KnArF9/projetDrone/README.md

# projetDrone
Projet électronique d'un drone
  - KiCad schéma, PCB
  - Rapport
  - Code tests unitaires
