KnArF9/projetDrone/rapportFinalDrone.pdf

## Cégep de Sherbrooke

## Technologie de systèmes ordinés

## Documentation projet Drone

## Pour le cours de ISO

## Pour : M. Pierre Bergeron

## Par : François Archambault

## Session Automne 2020

## Table des matières:

### INTRODUCTION AU PROJET :

Le but de ce projet était de concevoir l’électronique d’un drone et de le faire fonctionner. Pour ce rapport, je ne vais que traiter du côté matériel du projet parce que je n’ai pas vraiment commencé la programmation et l’application en Java n’est pas commencée.

Voici le schéma fonctionnel de mon projet :

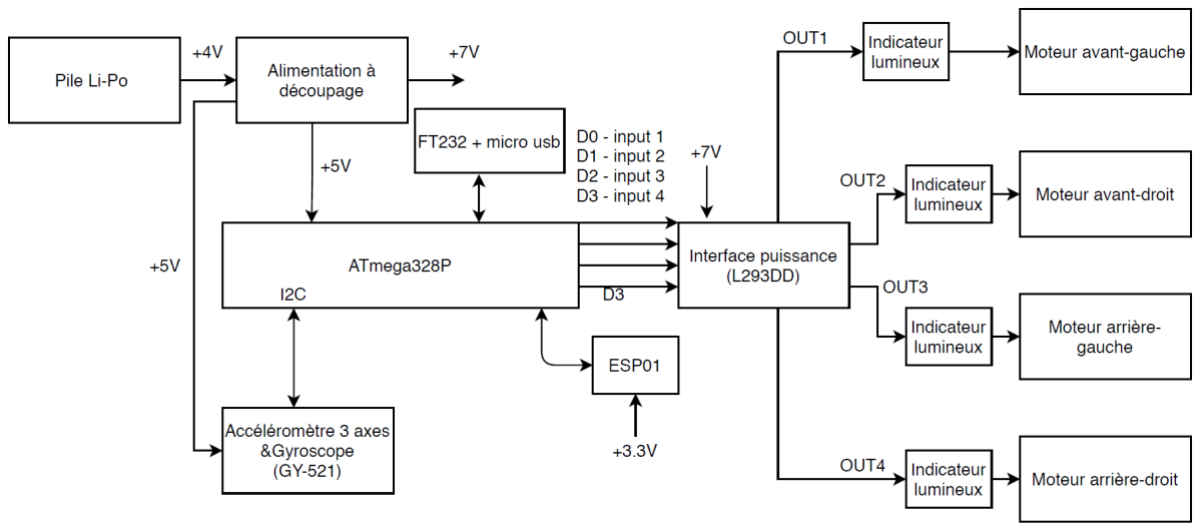
[picture p1: figure]

Figure 1

Il y a quelques erreurs dans ce schéma, mais malgré cela, le fonctionnement de base est comprenable. L’électronique du drone sera alimenté par une petite batterie Li-Po 4.5volts et 1.5 A/heure. Il y a un microcontrôleur qui gère le traitement des données du gyroscope, de l’esp01 et il contrôle les ponts en H des moteurs. Le gyroscope fournit au microcontrôleur des données sur l’accélération et la position en x et y du drone. L’esp01 gère la connexion Wi-Fi avec la future application Java sur cellulaire. Plusieurs témoins lumineux sont présents pour indiquer dans quel sens les moteurs tournent. L’alimentation à découpage monte la tension à 7v ou 9v pour alimenter les moteurs (en fait les ponts en H).

### CHOIX DES TECHNOLOGIES :

J’ai décidé de travailler avec un Atmega328PB parce que je commence à bien le connaitre et souvent, dans d’autres projets, j’ai dû travailler avec ce microcontrôleur. L’Atmega328PB a assez de pins PWM pour permettre le bon fonctionnement du drone. Pour le projet, j’ai mis le bootloader de Arduino pour pouvoir utiliser l’IDE et les librairies d’Arduino.

Les autres pièces ont été suggérées par le professeur. Honnêtement, je n’aime pas beaucoup l’esp01 parce qu’il n’est vraiment pas stable et il y a souvent des problèmes de communications. Mais bon… Ça marche quand même et ça ne coûte presque rien!

Je ne connaissais pas le gyroscope, mais j’avais déjà utilisé les ponts en H dans un projet personnel (bateau téléguidé).

### EXPLICATIONS DU SCHÉMA ÉLECTRIQUE :

(Le schéma électrique se trouve dans l’annexe 2 à la fin du document)

Le schéma électrique a été fait avec KiCad et il y a 4 parties au schéma. Les parties sont : alimentation, microcontrôleur et gyroscope, moteurs et esp01.

Alimentation : Dans cette partie, toutes les connexions de l’alimentation à découpage sont présentes ainsi que les régulateurs 5v et 3v3. Il y a aussi le jumper qui permet de choisir entre une tension de sortie de 7 ou 9 volts. (Figure 2)

Microcontrôleur : Dans cette partie, il y a les connexions du FT232 qui sert à la communication série entre un ordinateur et l’Atmega328PB. Il y a aussi le gyroscope qui est connecté au microcontrôleur en I2C. Il y a aussi les jumpers qui servent à contrôler les liens séries entre l’esp01, le FT232 et l’Atmega328PB. (Figure 3)

Moteurs : Dans cette partie, il y a les moteurs, les témoins lumineux et les ponts en H. Plusieurs pins des ponts en H sont connectés à des sorties du microcontrôleur (Les Dx ou Ax). Pour réussir à appliquer des PWMs sur les moteurs, il faut utiliser les pins enables des ponts en H et les pins inputs. Les pins inputs servent à choisir sur quel moteur le PWM va être appliqué et c’est sur les pins enables que le PWM va être transmis au moteur. Exemple : Le moteur 1 est connecté à l’input 1 et 2 d’un pont en H. Si l’input #1 est à un niveau haut, le moteur va aller dans le sens antihoraire et si c’est l’input #2 qui est à un niveau haut, le moteur va aller dans le sens horaire. Cependant, pour fonctionner il faut que le pin enable du moteur soit à un niveau haut! Si un PWM est appliqué sur la pin enable, le PWM va se retrouver dans le moteur. (Figure 4)

Esp01 : Dans cette partie, il n’y a que l’esp01 avec les boutons pour le programmer et une del témoin pour démontrer que la connexion est bien présente. (Figure 5)

### PROBLÈMES RENCONTRÉS :

Plusieurs problèmes sur le matériel sont survenus durant la conception. Dans la première version du drone, il y avait plusieurs erreurs de branchements entre le microcontrôleur et les ponts en H qui contrôlent les moteurs. Dans la première version, l’ATmega328PB n’aurait pas pu générer des PWMs sur tous les sens des moteurs. Malgré les erreurs, le PCB a été fabriqué et assemblé. Le PCB était fonctionnel sauf pour les PWMs. Le microcontrôleur fonctionnait bien ainsi que la communication série. Le PCB a malheureusement surchauffé à cause d’une erreur de son concepteur en branchant la batterie. Le cavalier qui donnait une référence (7v ou 9v) pour le circuit d’alimentation du drone a été enlevé et le circuit a brulé.

Il a donc fallu une version 2 du PCB avec les corrections nécessaires pour le fonctionnement des PWMs. Le PCB fut monté et à la plus grande joie du concepteur, tout est fonctionnel dans la version 2 de la plaque.

## ESP01 :

Dans le projet du drone, l’esp01 sert à faire le lien entre l’application cellulaire qui va envoyer les changements voulus et le microcontrôleur qui contrôle les moteurs du drone. L’esp01 reçoit des trames par le port série. Premièrement, l’utilisateur doit connecter l’application avec l’esp01 du drone. Il doit aller dans la section configuration de l’application et entrer l’IP, le port et l’ID pour la connexion (Dans ce projet : Port : 8888 & ID : crap8266). Si l’utilisateur demande de changer la direction du drone en appuyant sur une direction (4 boutons sur l’application), la trame envoyée à l’esp01 par l’application sera la direction avec une petite étoile (ex : Front*). Si l’application envoie une vitesse (avec le curseur), la vitesse sera envoyée avec un « / » (ex : 56/).

Quand la trame vient du microcontrôleur, les informations ne sont plus des directions ou bien une vitesse, mais les valeurs X, Y, Z de l’accéléromètre qui se trouve sur la plaque du drone. La trame reçue ressemble à ça : « 1234 5667 6374/*». La première section de la trame est le X, la deuxième Y et finalement la troisième Z. La trame se termine avec « /* » parce que dans le code de l’esp01, l’esp01 écoute le port série jusqu’à temps qu’il voit une petite étoile (*). Une fois qu’il voit la petite étoile, il transmet la trame à l’application CodeNameOne. La trame envoyée sera donc : « 1234 5667 6374/».

## ATMEGA328PB :

Dans le projet, l’Atmega328PB est le microcontrôleur qui contrôle les moteurs (donc PWM) du drone. Il active les moteurs avec les trames qu’il reçoit de l’application CodeNameOne avec le lien que fait l’esp01. Les trames reçues ressemblent à cela : « Front*» ou bien «76/». Le programme de l’ATmega328PB écoute le port série qui est connecté avec l’esp01. Quand quelque chose arrive par le port série, les caractères sont mis un à un dans une variable string (command). Si le caractère reçu est une petite étoile (*), cela veut dire que c’est une direction qui a été envoyée et l’ATmega328PB fait les ajustements par rapport à la commande. S’il reçoit la commande « Front », il va faire avancer le drone.

Si le caractère reçu est « / », cela veut dire que c’est une vitesse qui a été envoyée. La vitesse influence le PWM généré sur les moteurs.

Quand il a reçu une trame, l’ATmega328PB construit une variable string (valeurACC) qui contient les valeurs X, Y et Z de l’accéléromètre. Cette variable va être envoyée à l’esp01 par le port série pour finalement être reçu par l’application sur cellulaire. L’application pourra ensuite afficher les données de l’accéléromètre.

### APPLICATION CODENAMEONE :

L’application cellulaire fait avec CodeNameOne et l’IDE NetBeans, sert à contrôler le drone à partir d’un cellulaire. Dans la fenêtre principale de l’application (Annexe 4 pour l’apparence de l’application), il y a trois parties. La première (en haut) permet de contrôler la direction du drone grâce aux quatre boutons qui figurent les directions Nord, Sud, Est et Ouest. Quand l’utilisateur appuie sur un des quatre boutons, l’application envoie une requête TCP vers l’esp01 qui se trouve sur le drone. Si l’utilisateur appuie sur le bouton qui fait avancer le drone, la commande (ou trame) envoyée sera : « Front* ».

La deuxième partie (curseur) sert à changer la vitesse du drone. Le curseur peut aller de 0 à 100. La trame envoyée sera : « 21/ ».

La troisième partie sert à afficher les valeurs de l’accéléromètre du drone (X, Y, Z).

Cependant, avant de pouvoir envoyer des commandes au drone, il faut connecter l’application avec le esp01. Pour cela, il faut aller dans le menu (3 petits points en haut à droite) et choisir l’onglet Configuration. Dans cette fenêtre, il est possible d’entrer l’IP, le port et l’ID de l’esp01 du drone. Si une des trois informations n’est pas valides, il n’y aura pas de connexion. L’ID sert à vérifier si les commandes arrivent bien du drone sur lequel l’application est connectée.

Sinon, dans le menu, il y a aussi un onglet « À propos de… » et un onglet « Quitter ». En cliquant sur l’onglet « À propos de… », un message apparait pour montrer la version de l’application et le nom du concepteur. En cliquant sur l’onglet « Quitter », l’application se ferme.

## TCP :

Le drone et l’application communiquent avec l’aide de trames. Ces trames sont envoyées avec le protocole de communication TCP. L’esp01 est en réalité un serveur TCP qui attend qu’un client se connecte. L’application joue le rôle du client. À chaque fois qu’une trame est envoyée à partir de l’application, l’application se connecte au serveur TCP de l’esp01 et une fois que le
commande a été envoyée, le client (donc l’application) se déconnecte du serveur. De son côté, l’esp01 est toujours en attente d’une connexion d’un client. Quand un client est connecté, il reçoit la trame, il envoie le contenu de la trame sur le port série et il attend une réponse du microcontrôleur. Une fois que le microcontrôleur a envoyé sa réponse, l’esp01 envoie le contenu de la réponse au client (l’application).

### FONCTIONNALITÉS FINALES OBTENUES :

Le drone fonctionne bien. Toutes les parties ont été évaluées. Les codes nécessaires au fonctionnement du drone sont aussi fonctionnels, mais il y a quand même une petite erreur dans le programme de l’application CodeNameOne. Si l’utilisateur connecte correctement l’application à l’esp01 et qu’ensuite, il décide de changer l’ID sans changer le reste, le drone va continuer à recevoir les commandes malgré le mauvais ID. Cependant, si l’utilisateur tente de mettre un mauvais ID dans le première connexion à l’esp01, l’accès sera refusé.

### ANNEXE 1 (SIMULATION 7 ET 9V) :

Simulation 7v :

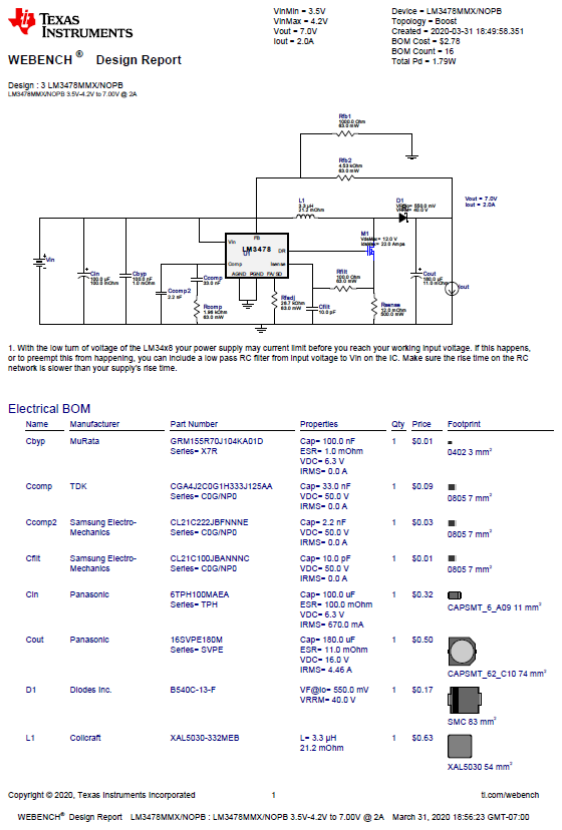
[picture p2: figure]
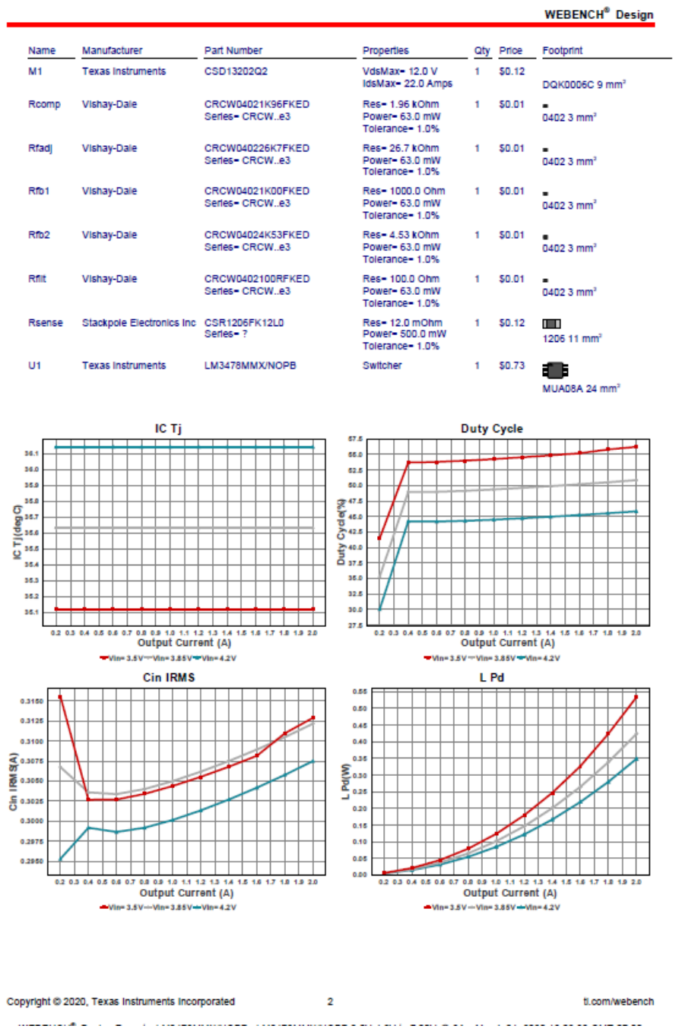
[picture p3: page 9]
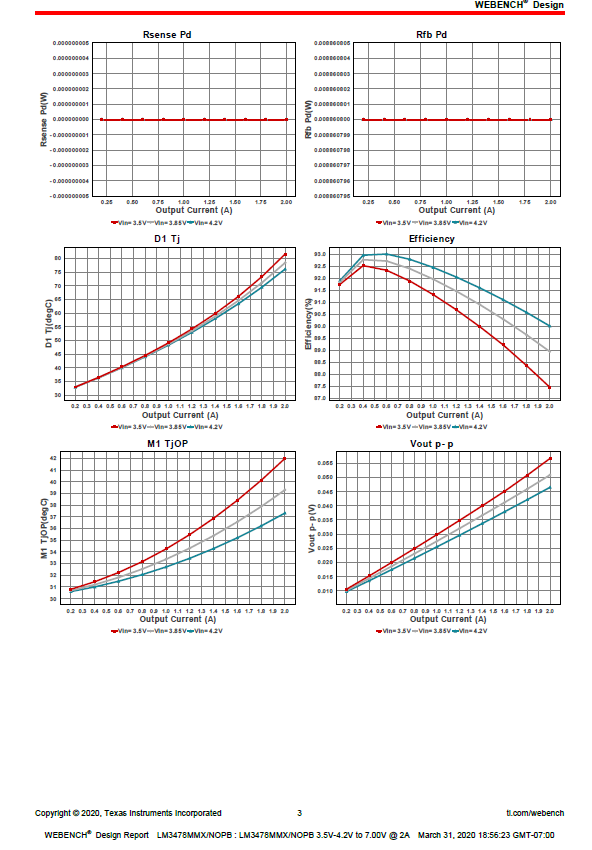
[picture p4: page 10]

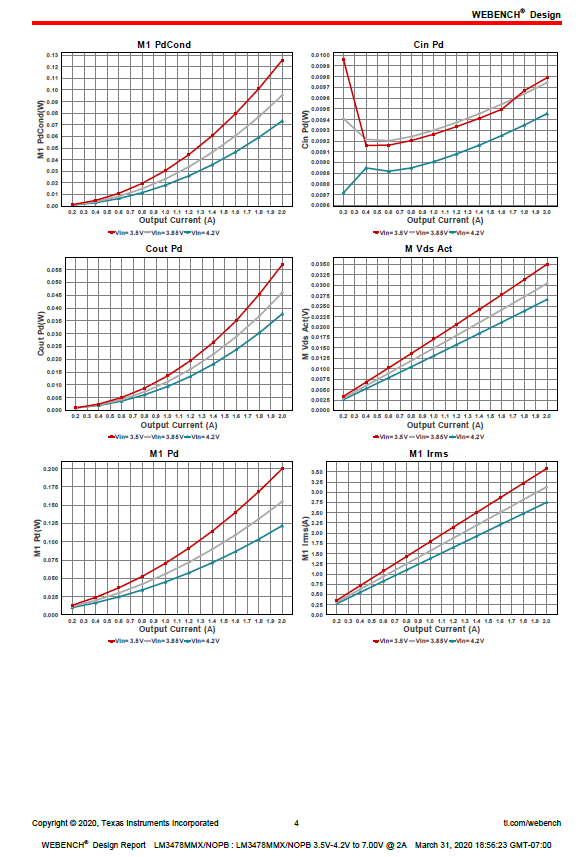
[picture p5: figure]
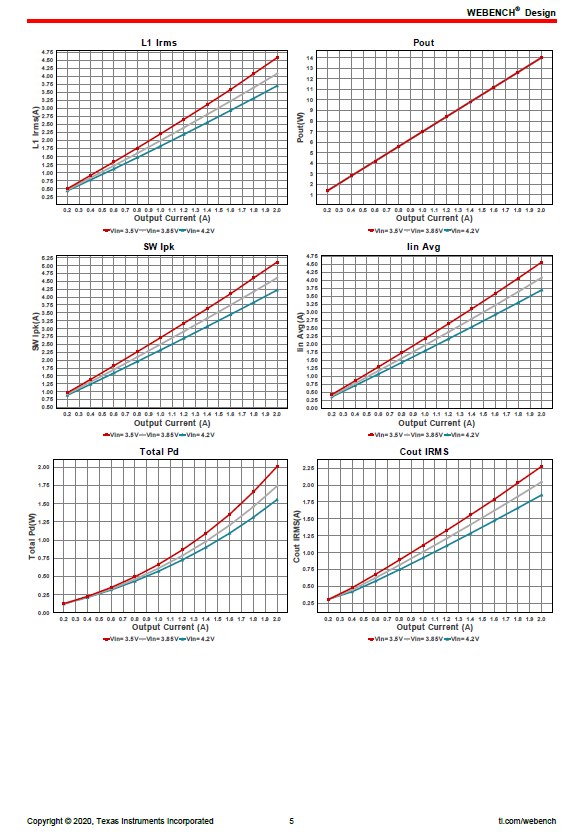
[picture p6: page 12]
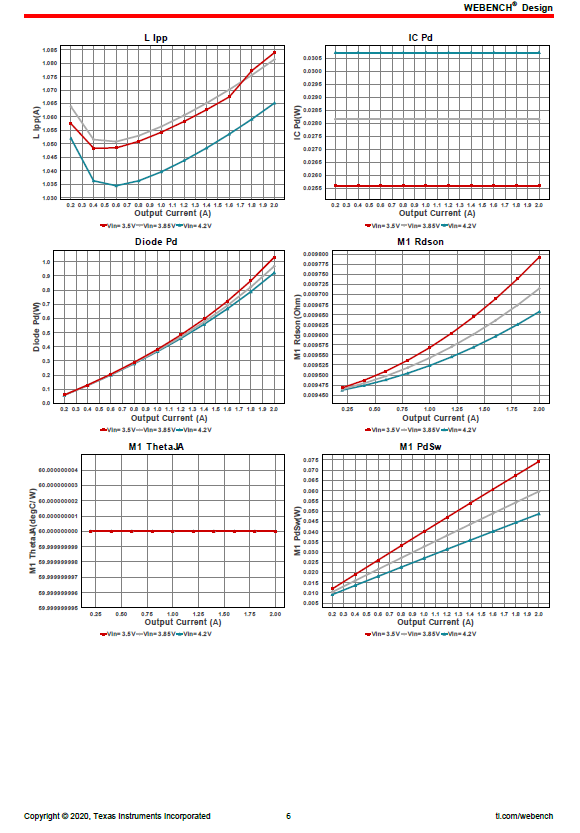
[picture p7: page 13]
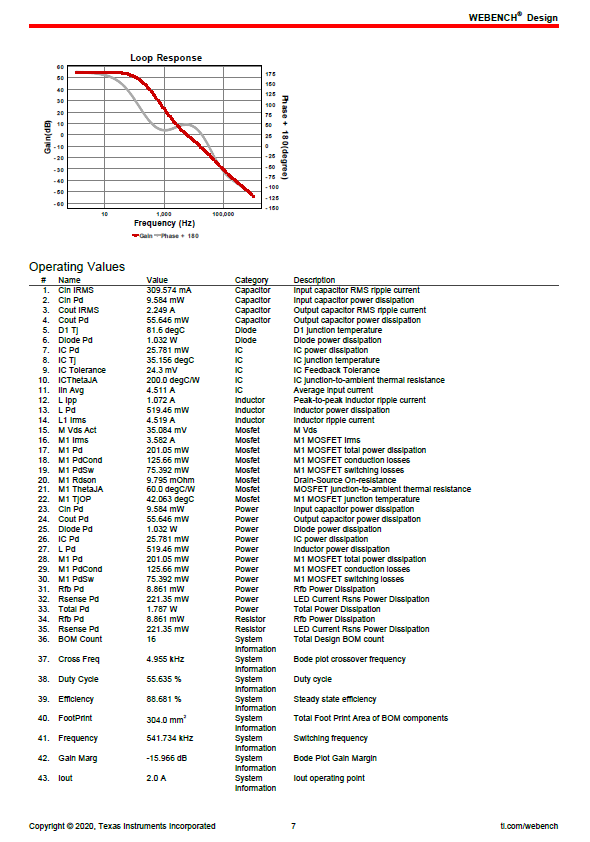
[picture p8: page 14]
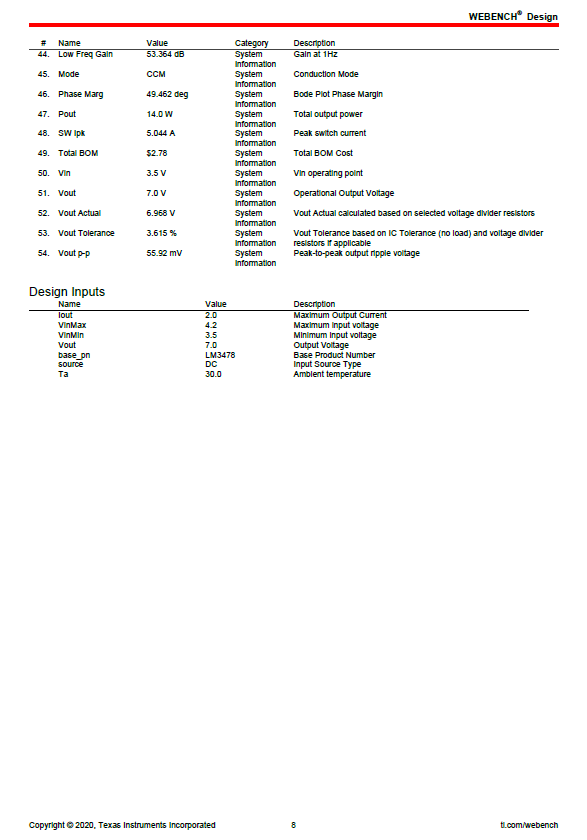
[picture p9: page 15]
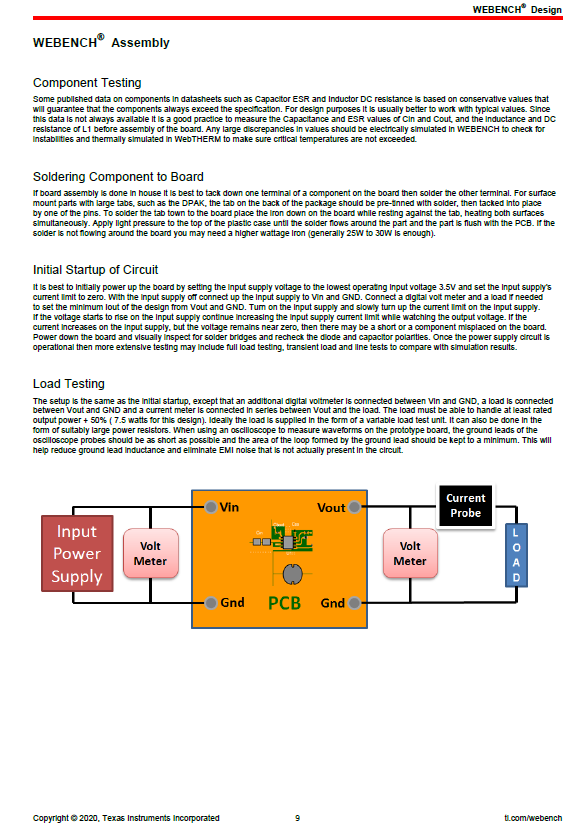
[picture p10: page 16]

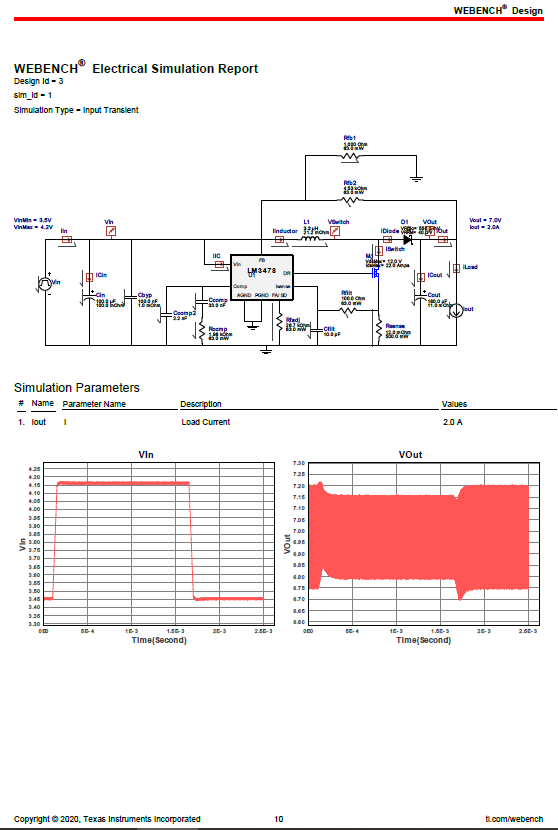
[picture p11: figure]
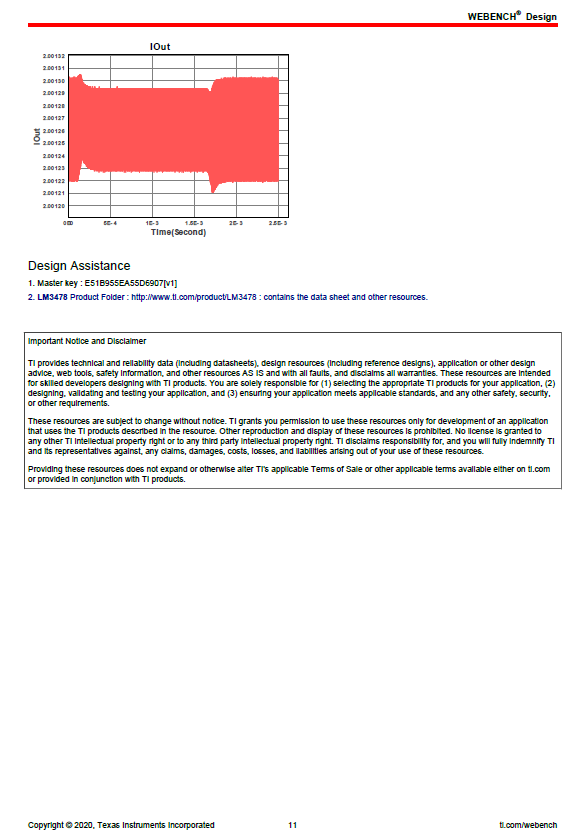
[picture p12: page 18]

Simulation 9v :

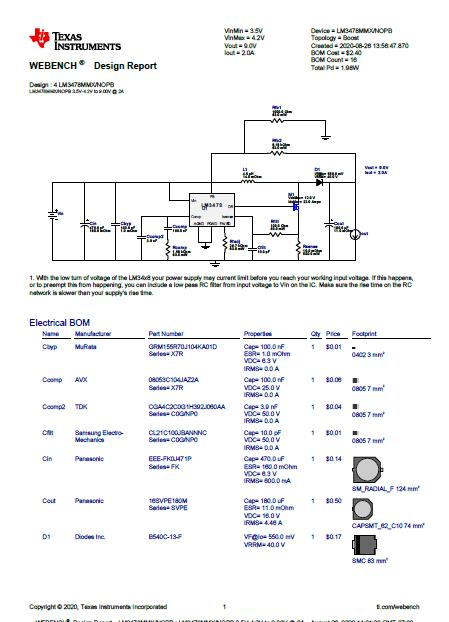
[picture p13: figure]
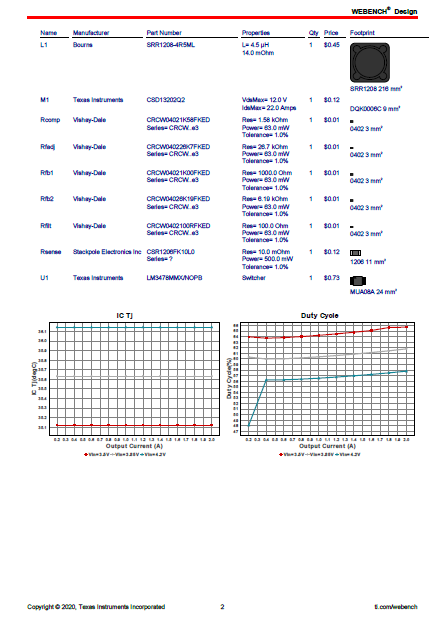
[picture p14: page 20]

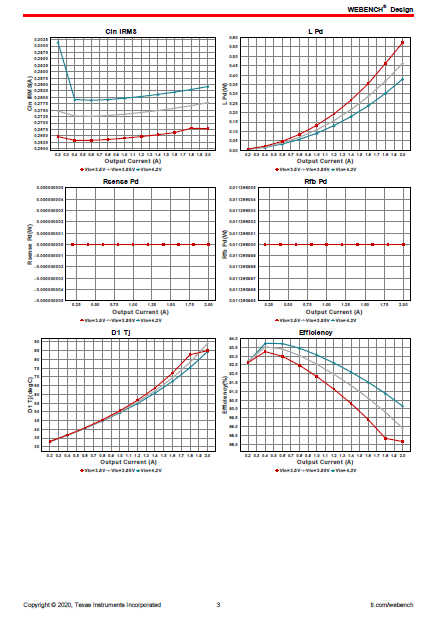
[picture p15: figure]
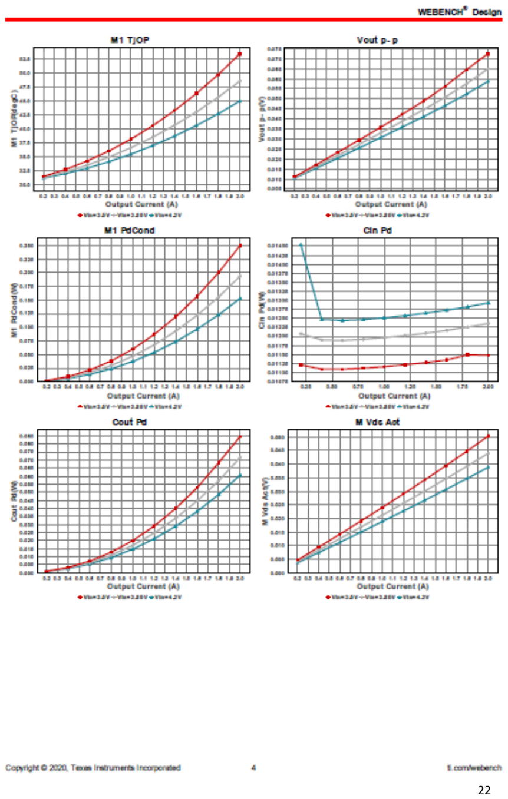
[picture p16: page 22]
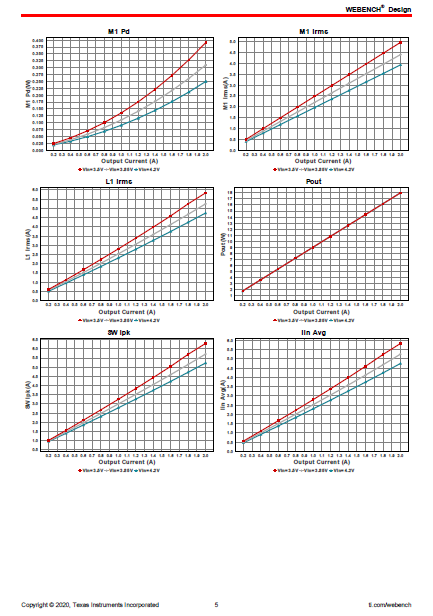
[picture p17: page 23]

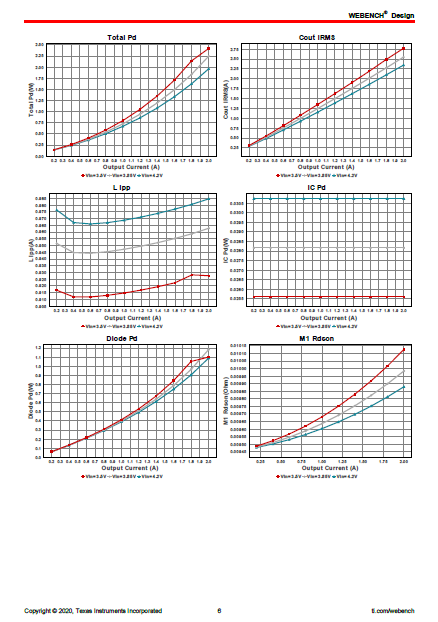
[picture p18: figure]

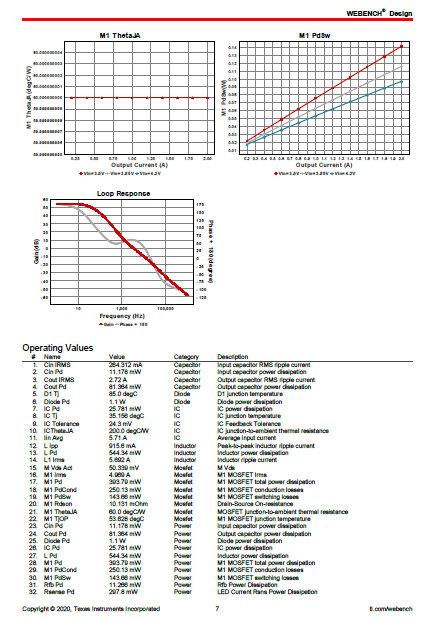
[picture p19: figure]

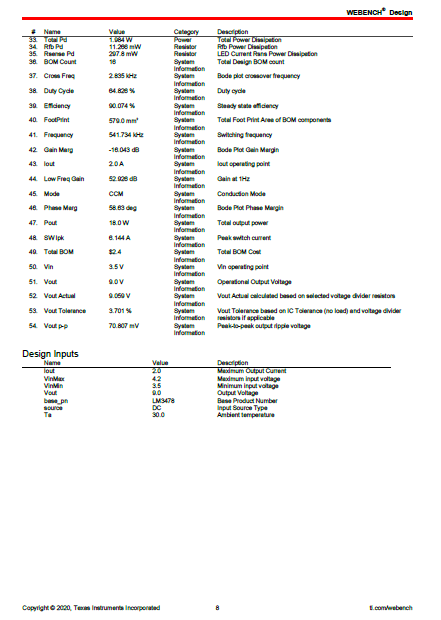
[picture p20: figure]

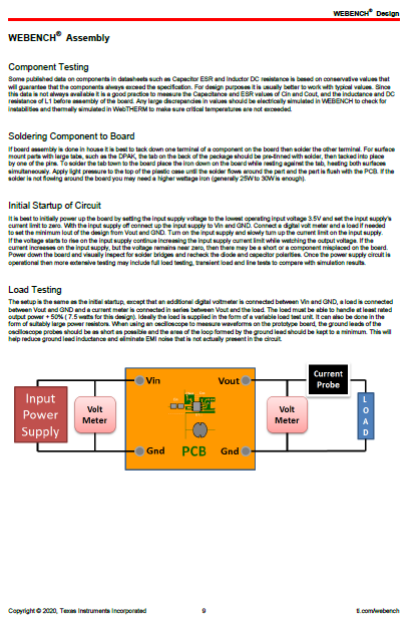
[picture p21: figure]

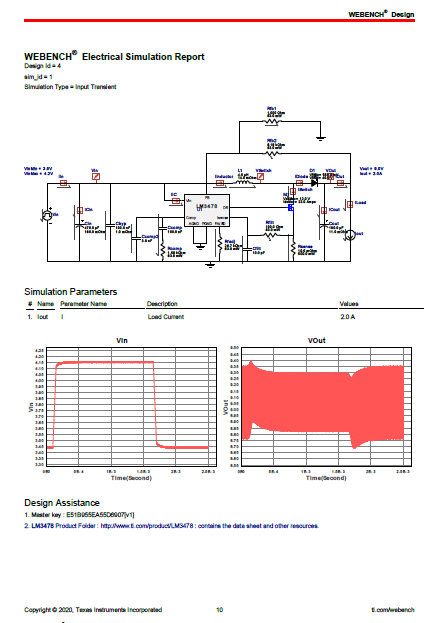
[picture p22: figure]

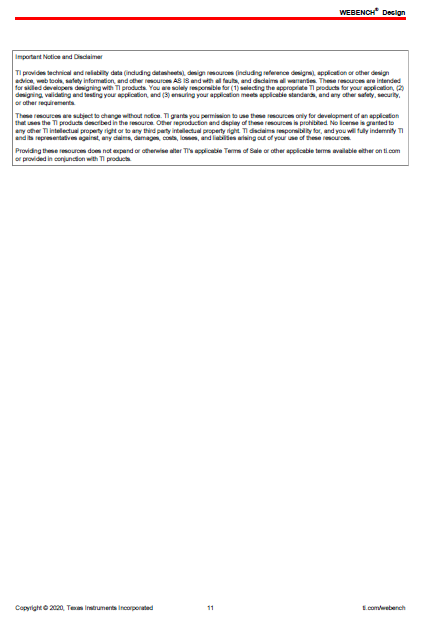
[picture p23: figure]

## Annexe 2(Schéma électrique) :

Figure 2

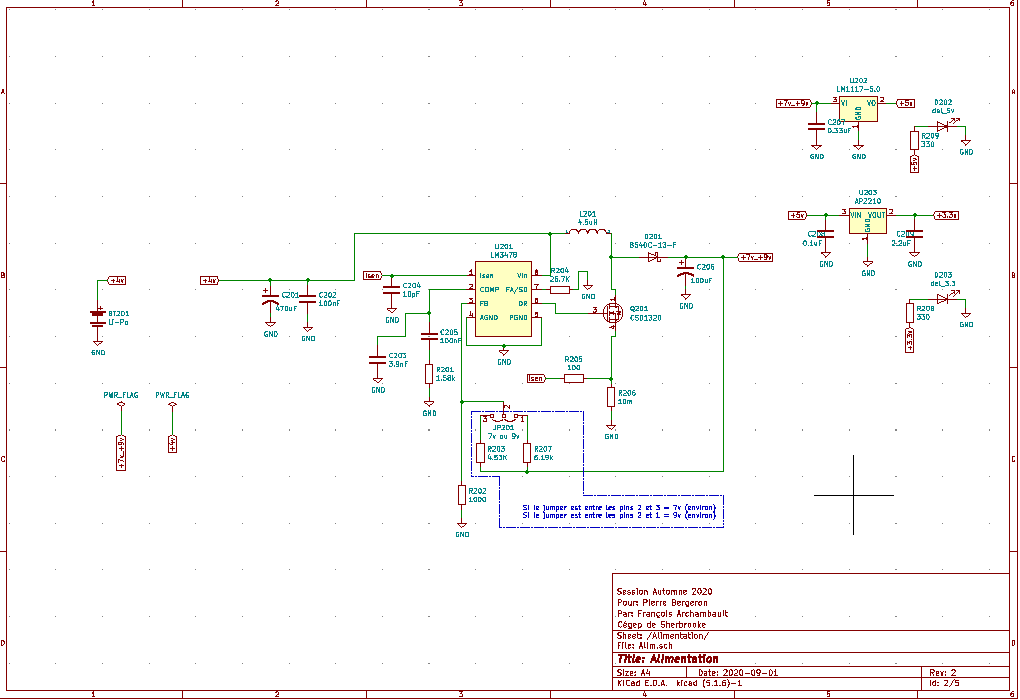
[picture p24: figure]

Figure 3

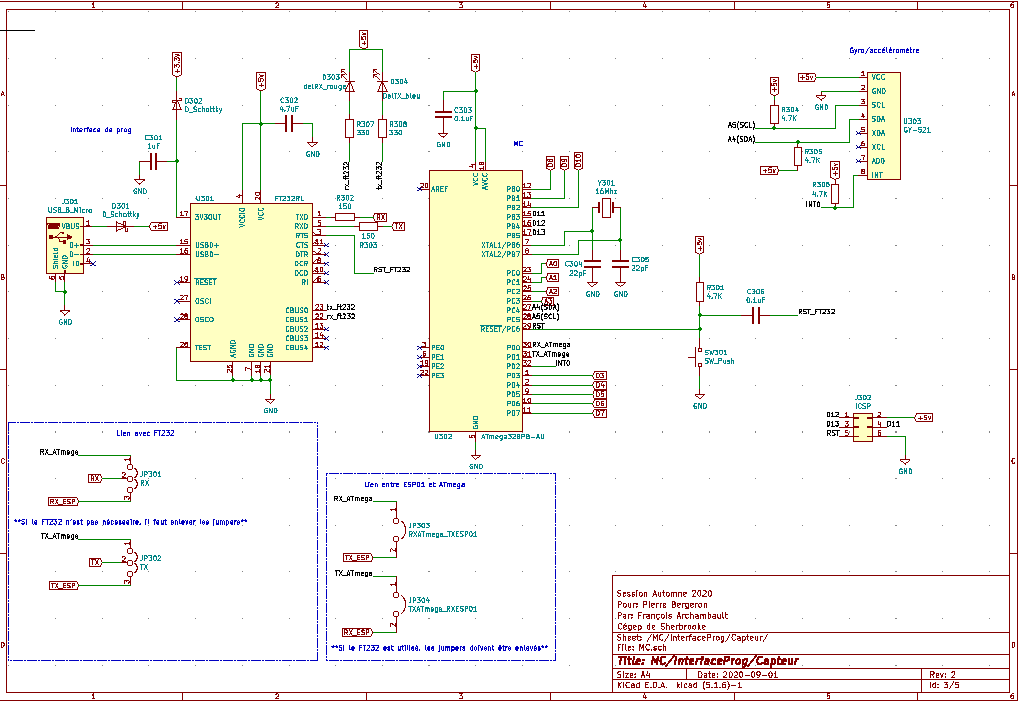
[picture p25: figure]

Figure 4

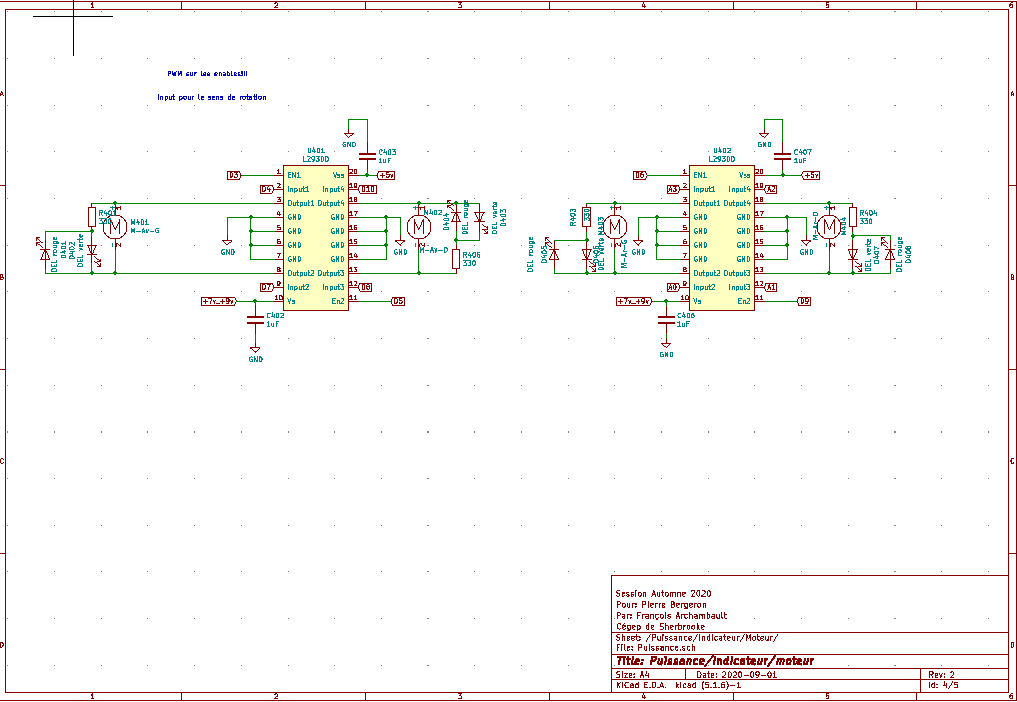
[picture p26: figure]

Figure 5

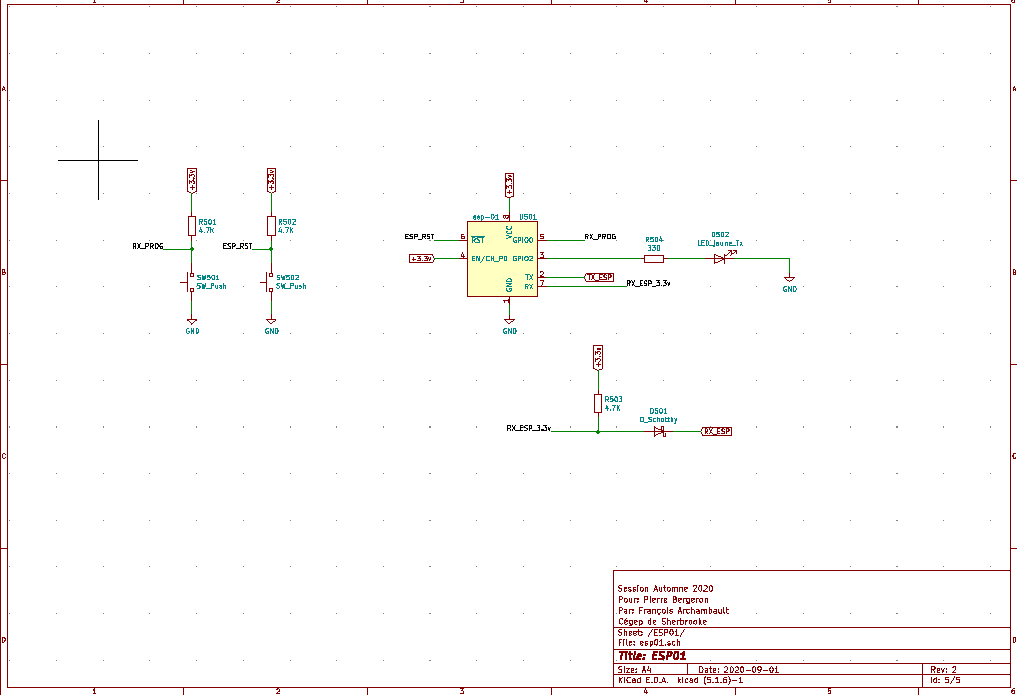
[picture p27: figure]

## Annexe 3 (vue 3D):

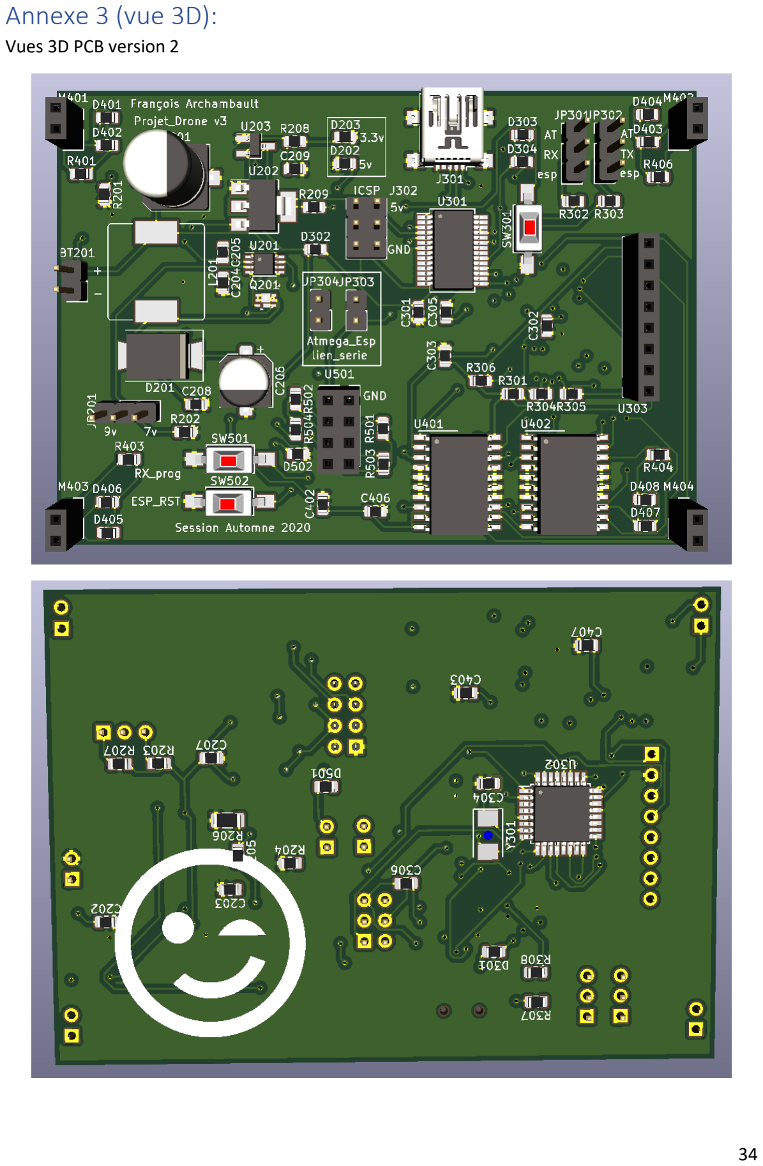
[picture p28: page 34]

Vues 3D PCB version 2

## Annexe 4 (Apparence des fenêtres de l’application):

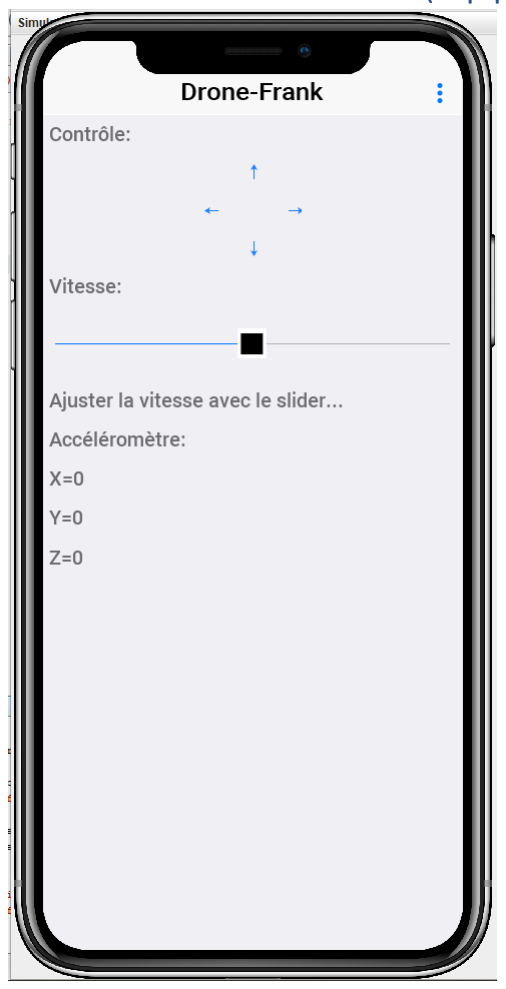
[picture p29: figure]
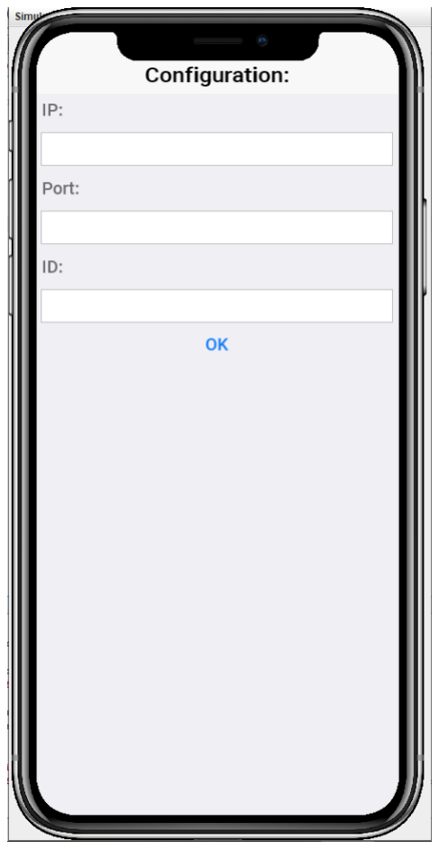
[picture p30: figure]
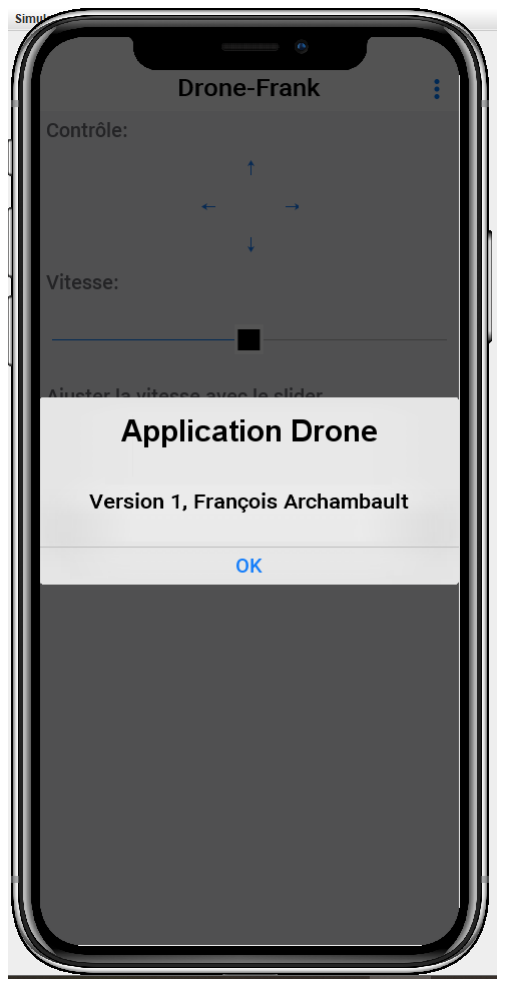
[picture p31: figure]

## Annexe 5 (CodeNameOne):

/*

* Programme de base pour le fonctionnement de l'application java.

* Par François Archambault

* Pour Pierre Bergeron

* Session Automne 2020

*/

package tso.cegepSherbrooke.droneFA;

import static com.codename1.ui.CN.*;

import com.codename1.ui.Display;

import com.codename1.ui.Form;

import com.codename1.ui.Dialog;

import com.codename1.ui.Label;

import com.codename1.ui.plaf.UIManager;

import com.codename1.ui.util.Resources;

import com.codename1.io.Log;

import com.codename1.ui.Toolbar;

import java.io.IOException;

import com.codename1.ui.layouts.BoxLayout;

import com.codename1.io.NetworkEvent;

import com.codename1.ui.Component;

import com.codename1.ui.layouts.FlowLayout;

/**

* This file was generated by <a href="https://www.codenameone.com/">Codename One</a> for the purpose

* of building native mobile applications using Java.

*/

public class monApp {

private Form current;

private Resources theme;

public void init(Object context) {

// use two network threads instead of one

updateNetworkThreadCount(2);

theme = UIManager.initFirstTheme("/theme");

// Enable Toolbar on all Forms by default

Toolbar.setGlobalToolbar(true);

// Pro only feature

Log.bindCrashProtection(true);

addNetworkErrorListener(err -> {

// prevent the event from propagating

err.consume();

if(err.getError() != null) {

Log.e(err.getError());

}

Log.sendLogAsync();

Dialog.show("Connection Error", "There was a networking error in the connection to " + err.getConnectionRequest().getUrl(), "OK", null);

});

}

public void start() {

if(current != null){

current.show();

return;

}

affichage aff = new affichage(); //appel à la classe affiche qui génère l'application

}

public void stop() {

current = getCurrentForm();

if(current instanceof Dialog) {

((Dialog)current).dispose();

current = getCurrentForm();

}

}

public void destroy() {

}

}

/*

* Fichier pour la section affiche de la fenêtre principale de l'application (classe affichage)

* Le programme gère aussi l'envoie des commandes et la résception des valeurs de l'accéléromètre par TCP

* Affiche les données de l'accéléromètre

* Par François Archambault

* Session Automne 2020

*/

package tso.cegepSherbrooke.droneFA; //doit avoir le même package que les autre fichier du programme

import static com.codename1.io.JSONParser.parse;

import static com.codename1.ui.CN.*;

import com.codename1.ui.Display;

import com.codename1.ui.Form;

import com.codename1.ui.Dialog;

import com.codename1.ui.Label;

import com.codename1.ui.plaf.UIManager;

import com.codename1.ui.util.Resources;

import com.codename1.io.Log;

import com.codename1.ui.Toolbar;

import java.io.IOException;

import com.codename1.ui.layouts.BoxLayout;

import com.codename1.io.NetworkEvent;

import com.codename1.io.Socket;

import com.codename1.io.SocketConnection;

import com.codename1.ui.Button;

import com.codename1.ui.Command;

import com.codename1.ui.Component;

import com.codename1.ui.Container;

import com.codename1.ui.Font;

import com.codename1.ui.FontImage;

import com.codename1.ui.Image;

import com.codename1.ui.Slider;

import com.codename1.ui.TextField;

import com.codename1.ui.events.ActionEvent;

import com.codename1.ui.layouts.BorderLayout;

import com.codename1.ui.layouts.FlowLayout;

import com.codename1.ui.layouts.GridLayout;

import com.codename1.ui.plaf.Border;

import com.codename1.ui.plaf.Style;

import java.io.InputStream;

import java.io.InputStreamReader;

import java.io.OutputStream;

import com.codename1.io.Util;

/**

*

* @author farch

*/

public class affichage extends Form

{

public Command cAProposDe; //onglet dans menu

public Command cQuitter; //onglet dans menu

public Command cConfig; //onglet dans menu

public String IP = ""; //variable pour l'IP public String PORT = ""; //variable pour le PORT

public String ID = ""; //variable pour l'ID

Label valueX = new Label("X=0"); //Labels qui vont accueillir les données de l'accéléramètre

Label valueY = new Label("Y=0"); //ne sont pas dans le constructeur parce que la méthode send a besoin de changer le texte des labels

Label valueZ = new Label("Z=0");

public affichage() //constructeur de la classe

{

setTitle("Drone-Frank"); //titre de l'application

setLayout( BoxLayout.y()); //layout de la fenêtre en box (bloc un par dessus l'autre)

Container panelControle = new Container(); //container

Container pGrid = new Container(); //

//instanciation de tous les labels utiles dans la fenêtre

Label lb = new Label("Contrôle: ");

Label vitesse = new Label("Vitesse: ");

Label value = new Label("Ajuster la vitesse avec le slider...");

Label accelerometre = new Label("Accéléromètre: ");

//instanciation des boutons utiles dans la fenêtre

Button bHaut = new Button("↑");

Button bBas = new Button("↓");

Button bGauche = new Button("←");

Button bDroite = new Button("→");

//Attribut une action au bouton. Ici c'est un appel à la méthode send avec une direction en paramètre

bHaut.addActionListener((e) -> send("Front*"));

bBas.addActionListener((e) -> send("Back*"));

bGauche.addActionListener((e) -> send("Gauche*"));

bDroite.addActionListener((e) -> send("Droite*"));

//section du slider

Style thumbStyle = new Style(); //pour mettre un curseur sur le slider

thumbStyle.setFont(Font.createSystemFont(Font.FACE_MONOSPACE, Font.STYLE_BOLD, Font.SIZE_LARGE), true);

Slider sliderVitesse = new Slider(); //instanciation

sliderVitesse.setEditable(true); //le slider peut changer de valeur

sliderVitesse.setMinValue(0); //MIN =0

sliderVitesse.setMaxValue(100); //MAX = 100

sliderVitesse.setProgress(50); //commence à 50 (milieu)

sliderVitesse.setThumbImage(FontImage.create("⬛", thumbStyle)); //le curseur est un carré

sliderVitesse.addActionListener(e -> { //attribut une action quand le slider change de valeur

Integer valueSelected = sliderVitesse.getProgress(); //valeur actuelle du slider (entre 0 et 100)

value.setText( valueSelected.toString() + "% de vitesse"); //change le texte de la vitesse pour afficher la vitesse (ex. 43% de vitesse)

String toSend = valueSelected.toString()+ "/"; //création de la string qui va être envoyée à l'esp01 par TCP

send(toSend); //appel la méthode send avec en paramètre la vitesse + / (ex. 34/)

});

//instanciation de labels vides pour remplir la grille pour faire le layout (nord, sud, est, ouest)

Label v1 = new Label("");

Label v2 = new Label("");

Label v3 = new Label("");

Label v4 = new Label("");

Label v5 = new Label("");

pGrid.setLayout(new GridLayout(3,3)); //grille de 3 par 3

panelControle.setLayout(new FlowLayout(Component.CENTER));

//ajoute à la grille tous les labels et les boutons pour faire le bon layout des directions

pGrid.add(v1);

pGrid.add(bHaut);

pGrid.add(v2);

pGrid.add(bGauche);

pGrid.add(v3);

pGrid.add(bDroite);

pGrid.add(v4);

pGrid.add(bBas);

pGrid.add(v5);

panelControle.add(pGrid); //ajoute la grille au panel

//ajoute tout à la fenêtre principale dans le bon ordre. (lb va être le premier en haut de la fenêtre et valuez le dernier)

add(lb);

add(panelControle);

add(vitesse);

add(sliderVitesse);

add(value);

add(accelerometre);

add(valueX);

add(valueY);

add(valueZ);

//onglet a propos de dans le menu

cAProposDe = new Command("À propos de...")

{

public void actionPerformed(ActionEvent ae) //quand appuyé

{

onAProposDe(); //appel à la méthode onAProposDe

}

};

//onglet Quitter de dans le menu

cQuitter = new Command("Quitter")

{

public void actionPerformed(ActionEvent ae)//quand appuyé

{

onQuitter();//appel à la méthode onQuitter

}

};

//onglet configuration de dans le menu

cConfig = new Command("Configuration")

{

public void actionPerformed(ActionEvent ae)//quand appuyé

{

onConfig();//appel à la méthode onQuitter

}

};

Toolbar tb = getToolbar(); //nouveau menu

tb.addCommandToOverflowMenu(cConfig); //ajoute les onglets au menu

tb.addCommandToOverflowMenu(cAProposDe);

tb.addCommandToOverflowMenu(cQuitter);

show(); //affiche les composantes de la fenêtre

}

public void onConfig()

{

new config(this); //appel à la classe config (autre fenêtre qui sert à l'affichage de la fenêtre de config

}

public void onQuitter()

{

System.exit(0); //quitte l'application

}

public void onAProposDe()

{

Dialog.show("Application Drone", "Version 1, François Archambault", "OK", null); //affiche un message

}

public void send(String bufferEnvoie) //méthode qui envoie une commande à l'esp01 par TCP

{

try

{

// Ouverture de la connexion au serveur sur le port 8888 (adresse localhost OK avec simulateur mais pas avec vrai mobile)

Socket.connect(IP, Integer.parseInt(PORT), new SocketConnection()

{

// Surcharge de la méthode pour la gestion des erreurs de connexion

public void connectionError(int errorCode, String message)

{

System.out.println("Error");

}

// Surcharge de la méthode lorsque la connexion est établie

public void connectionEstablished(InputStream is, OutputStream os) {

try {

if(isConnected()) {

os.write(bufferEnvoie.getBytes()); // Envoi le buffer de caractères contenant la commande

try

{

Thread.sleep(100); // Délai pour recevoir la réponse...

}

catch(Exception e)

{

System.out.println(e.toString());

}

InputStreamReader isr = new InputStreamReader(is); // Définir la source de donnée et le canal de communication

String inputLine;

StringBuffer response = new StringBuffer();

int nb = 0;

do

{

char[] cbuff = new char[1000];

nb=isr.read(cbuff, 0, 100); // Lecture de la réponse en cours (peut-être contenu dans plusieurs trames TCP)

inputLine = new String(cbuff);

response.append(inputLine);

}while (is.available()>0);

isr.close(); // Fermeture de la connexion

//Affiche la réponse reçue

System.out.println(response.toString());

String[] valAcc1 = Util.split(response.toString(),"/"); //divise la réponse au "/" et c'Est mis dans un tableau de string

String[] valAcc2 = Util.split(valAcc1[0].toString()," ");//divise le tableau valAcc1 à l'index 0 au " " et c'Est mis dans un autre tableau de string

int longueurAcc = valAcc2[5].length(); //prend la longueur de l'ID (valAcc2[5])

int longueurID = ID.length();

//if(valAcc1[5].equals(ID))

if(longueurAcc == longueurID) //compare la longueur de l'ID et de l'ID reçu par TCP. SI pareil

{

valueX.setText("X: " + valAcc2[2].toString()); //change les valeurs de x y z par les nouvelles

valueY.setText("Y: " + valAcc2[3].toString());

valueZ.setText("Z: " + valAcc2[4].toString());

// ID = valAcc[3];

}

for(int i=0; i< valAcc2.length;i++) //vide le tableau

{

//valAcc1[i]="";

valAcc2[i]="";

}

}

} catch(Exception err) {

err.printStackTrace();

}

}

});

}

catch(Exception e)

{

e.printStackTrace();

}

}

}

/*

* Fichier de la fenêtre de configuration. Permet de changer les variables de connexion de l'application.

* Par François Archambault

* Session Automne 2020

*/

package tso.cegepSherbrooke.droneFA;

import static com.codename1.ui.CN.*;

import com.codename1.ui.Display;

import com.codename1.ui.Form;

import com.codename1.ui.Dialog;

import com.codename1.ui.Label;

import com.codename1.ui.plaf.UIManager;

import com.codename1.ui.util.Resources;

import com.codename1.io.Log;

import com.codename1.ui.Toolbar;

import java.io.IOException;

import com.codename1.ui.layouts.BoxLayout;

import com.codename1.io.NetworkEvent;

import com.codename1.ui.Button;

import com.codename1.ui.Component;

import com.codename1.ui.Container;

import com.codename1.ui.TextField;

import com.codename1.ui.events.ActionEvent;

import com.codename1.ui.events.ActionListener;

import com.codename1.ui.layouts.FlowLayout;

import com.codename1.ui.plaf.Border;

import com.codename1.ui.plaf.Style;

public class config extends Form //classe qui hérite de Form

{

public affichage m_sParent; //objet de classe affichage

public TextField tf_IP = new TextField(); //3 textFields pour IP, PORT, ID

public TextField tf_PORT = new TextField();

public TextField tf_ID = new TextField();

public config(affichage sParent) //constructeur

{

m_sParent = sParent; //permet de revenir à la fenêtre principale

setTitle("Configuration:"); //titre

setLayout(BoxLayout.y()); //création du layout de la fenêtre

add(new Label("IP: " ));

add(tf_IP);

add(new Label("Port: " ));

add(tf_PORT);

add(new Label("ID: " ));

add(tf_ID);

Button bOK = new Button("OK"); //instanciation d'un bouton OK

bOK.addActionListener((e) -> btnOK()); //quand bouton OK est appuyé

bOK.addActionListener((e) -> m_sParent.showBack()); //retourne à la fenêtre principale

add(bOK); //ajoute le bouton à la fenêtre config

show(); //affiche les composantes

}

public void btnOK() //méthode appelée quand le bouton OK est appuyé

{

m_sParent.IP = tf_IP.getText(); //prend les valeurs écrites dans les textFields pour changer les variables de connexion dans la fenêtre principale

m_sParent.PORT = tf_PORT.getText();

m_sParent.ID = tf_ID.getText();

}

}

## Annexe 6 (esp01):

/*

* Programme du ESP01 pour le projet du drone.

* Serveur TCP qui transmet les commandes de l'application cellulaire au microcontrôleur du drone et qui renvoie à l'application

* les données de l'accéléromètre qui est sur le drone.

* Par François Archambault

* Pour Pierre Bergeron

* Session Automne 2020

*/

//section include

#include <ESP8266WiFi.h>

#include <WiFiClient.h>

int port = 8888; //Port number

WiFiServer server(port);//objet serveur de classe WifiServer (pour serveur TCP)

//Server connect to WiFi Network

const char *ssid = "DSO"; //Enter your wifi SSID

const char *password = "247-367-sh"; //Enter your wifi Password

int count=0;

String command; //string qui va être envoyée au client TCP (l'application) et qui va contenir les vleurs de l'accéléromètre

String dataReceive; //variable qui va accueillir les caractères qui arrivent par le port série

void setup()

{

Serial.begin(115200); //pour débugger et aussi pour envoyer les informations par le port série (baudrate: 115200)

WiFi.mode(WIFI_STA);

WiFi.begin(ssid, password); //Connexion au wifi

// Wait for connection

Serial.println("Connecting to Wifi");

// Attente de connexion de l'ESP8266 au routeur WIFI

while (WiFi.status() != WL_CONNECTED)

{

delay(500);

Serial.print(".");

}

// Indique l'adresse IP obtenue pour l'ESP8266

Serial.println("");

Serial.print("Connected to ");

Serial.println(ssid);

Serial.print("IP address: ");

Serial.println(WiFi.localIP());

// Départ du serveur TCP

server.begin();

Serial.print("Open a connection to IP:");

Serial.print(WiFi.localIP()); //affiche l'adresse IP. Utile pour la connexion avec l'apploication cellulaire

Serial.print(" on port ");

Serial.println(port); //8888

}

void loop()

{

WiFiClient client = server.available(); // Ouverture d'un socket vers le client que se connecte au serveur TCP

if (client) // Le client existe?

{

if(client.connected()) // Le client est bien connecté?

{

while(client.connected()) //tant que le client est connecté

{

while(client.available()>0) // Lecture de la requête du client (peut être dans plusieurs trames TCP)

{

Serial.write(client.read());// Lecture de la requête du client et l'écrit sur le port série pour le microcontrôleur

}

while(Serial.available()) //quand quelque chose est transféré par le port série

{

dataReceive = (char)Serial.read(); //caractères 1 par 1

if(dataReceive == "*")//si le caractère == *

{

client.println(command); //envoie la trame (accéléromètre) au client (TCP)

command = ""; //remise à zéro de command

break; //sortir du while

}

else //si c'Est différent d'unr étoile (*)

{

command = command + dataReceive; //accumule les informations de l'accéléromètre

}

}

}

client.stop(); // Fermeture du socket TCP

}

}

}

## Annexe 7 (ATmega328PB):

/*

* Programme pour l'ATmega328PB pour le projet du drone. Le programme entend de recevoir une commande par le port série. La commande

* va être une direction ou bien une vitesse. Le programme contrôle les moteurs et l'accéléromètre. Une fois que la commande a été exécuté, le programme

* envoie par le port série les valeurs de l'accéléromètre pour qu'elles soient affichées dans l'application cellulaire.

* Par François Archambault

* Pour Pierre Bergeron

* Session Automne 2020

*/

//include

#include<Wire.h>

#include <math.h>

//******Moteur 1***********

#define delVerteM1 4 //choisir le sens

#define delRougeM1 7

#define enableM1 3 //le pwm est appliqué sur cette pin

//******Moteur 2***********

#define delVerteM2 10//choisir le sens

#define delRougeM2 8

#define enableM2 5//le pwm est appliqué sur cette pin

//******Moteur 3***********

#define delVerteM3 A3//choisir le sens

#define delRougeM3 A0

#define enableM3 6//le pwm est appliqué sur cette pin

//******Moteur 4***********

#define delVerteM4 A2//choisir le sens

#define delRougeM4 A1

#define enableM4 9//le pwm est appliqué sur cette pin

const int MPU=0x68;//pour accéléromètre

int16_t AcX,AcY,AcZ; //variables qui vont accueillir les données de l'accéléromètre

String command; //variable qui va accueillir la commande reçue par le port série

String dataReceive; //va accuillir 1 par 1 les caractères reçus par le port série avant qu'il soit mis dans command

String valeurACC = ""; //variable string qui va accuillir la string qui sera envoyée par le port série pour envoyer les valeurs de l'accéléromètre

String myStringX; //les trois variables pour aider à la conversion en string des valeurs int x, y, z

String myStringY;

String myStringZ;

void setup()

{

Serial.begin(115200); //port série baudrate de 115200

Wire.begin(); //pour accéléromètre

Wire.beginTransmission(MPU);

Wire.write(0x6B);

Wire.write(0);

Wire.endTransmission(true);

//définition des moteurs comme des sorties

pinMode(delVerteM1, OUTPUT);

pinMode(delRougeM1, OUTPUT);

pinMode(enableM1, OUTPUT);

pinMode(delVerteM2, OUTPUT);

pinMode(delRougeM2, OUTPUT);

pinMode(enableM2, OUTPUT);

pinMode(delVerteM3, OUTPUT);

pinMode(delRougeM3, OUTPUT);

pinMode(enableM3, OUTPUT);

pinMode(delVerteM4, OUTPUT);

pinMode(delRougeM4, OUTPUT);

pinMode(enableM4, OUTPUT);

//va juste allumer les dels vertes donc tous les moteurs vont aller du même sens

digitalWrite(delVerteM1, HIGH);

digitalWrite(delVerteM3, HIGH);

digitalWrite(delRougeM1, LOW);

digitalWrite(delRougeM3, LOW);

digitalWrite(delVerteM2, HIGH);

digitalWrite(delVerteM4, HIGH);

digitalWrite(delRougeM2, LOW);

digitalWrite(delRougeM4, LOW);

}

void loop()

{

Wire.beginTransmission(MPU);

Wire.write(0x3B);

Wire.endTransmission(false);

Wire.requestFrom(MPU,14,true);

int AcXoff,AcYoff,AcZoff;

int myVitesse;

char arrayVitesse[5];

while(Serial.available())

{

dataReceive = (char)Serial.read();//caractères 1 par 1

if(dataReceive == "*")//si le caractère == * Ca veut dire que c'est une direction qui a été envoyée

{

break; //sortir du while

}

else if(dataReceive == "/")//si le caractère == / Ca veut dire que c'est une vitesse qui a été envoyée

{

break; //sortir du while

}

else

{

command = command + dataReceive;//accumule les informations de la commande (ex: Front)

}

}

AcXoff = 0; //pour correction du x y z (dans code de base de l'accéléromètre)

AcYoff = 300;

AcZoff = 0;

//read accel data

AcX=(Wire.read()<<8|Wire.read()) + AcXoff;

AcY=(Wire.read()<<8|Wire.read()) + AcYoff;

AcZ=(Wire.read()<<8|Wire.read()) + AcYoff;

myStringX = String(AcX); //met les ints en strings pour pouvoir les envoyer par le port série

myStringY = String(AcY);

myStringZ = String(AcZ);

valeurACC = " " + myStringX + " " + myStringY + " " + myStringZ + " " + "crap8266/*" + " "; //création de la string qui sera envoyée comme réponse à la commande reçue

if(command.length() <4 && command.length() > 0) //si c'Est une vitesse valide

{

command.toCharArray(arrayVitesse,command.length()+1); //string en tableau de char

myVitesse = (atoi(arrayVitesse)); //tableau de char en int pour pouvoir utiliser la vitese avec analogWrite

if(myVitesse == 0) //éteint le drone

{

Serial.println(valeurACC);

analogWrite(enableM3, 0);

analogWrite(enableM4, 0);

analogWrite(enableM1, 0);

analogWrite(enableM2, 0);

}

else //pWM avec la vitesse sur les 4 moteurs

{

Serial.println(valeurACC);

analogWrite(enableM3, myVitesse);

analogWrite(enableM4, myVitesse);

analogWrite(enableM1, myVitesse);

analogWrite(enableM2, myVitesse);

}

}

if(command == "Front") //si la commande reçue est Front

{

Serial.println(valeurACC); //envoie les valeurs de l'accéléromètre

analogWrite(enableM3, (myVitesse + 150));//ajuste la vitesse des moteurs avec la direction voulue

analogWrite(enableM4, (myVitesse + 150));

analogWrite(enableM1, myVitesse);

analogWrite(enableM2, myVitesse);

command =""; //remet la commande à zéro

}

else if(command == "Back")//si la commande reçue est Back

{

Serial.println(valeurACC); //envoie les valeurs de l'accéléromètre

analogWrite(enableM1, (myVitesse + 150)); //ajuste la vitesse des moteurs avec la direction voulue

analogWrite(enableM2, (myVitesse + 150));

analogWrite(enableM3, myVitesse);

analogWrite(enableM4, myVitesse);

command ="";//remet la commande à zéro

}

else if(command == "Gauche")//si la commande reçue est Gauche

{

Serial.println(valeurACC); //envoie les valeurs de l'accéléromètre

analogWrite(enableM2, (myVitesse + 150));//ajuste la vitesse des moteurs avec la direction voulue

analogWrite(enableM4, (myVitesse + 150));

analogWrite(enableM1, myVitesse);

analogWrite(enableM3, myVitesse);

command ="";//remet la commande à zéro

}

else if(command == "Droite")//si la commande reçue est Droite

{

Serial.println(valeurACC); //envoie les valeurs de l'accéléromètre

analogWrite(enableM1, (myVitesse + 150));//ajuste la vitesse des moteurs avec la direction voulue

analogWrite(enableM3, (myVitesse + 150));

analogWrite(enableM2, myVitesse);

analogWrite(enableM4, myVitesse);

command ="";//remet la commande à zéro

}

command ="";//remet la commande à zéro

valeurACC = ""; //remet les valeurs de l'accéléromètre à zéro pour ne pas renvoyer les mêmes données

delay(100);

}
