KnArF9/projetDrone/Drone/schema_bloc_drone.pdf

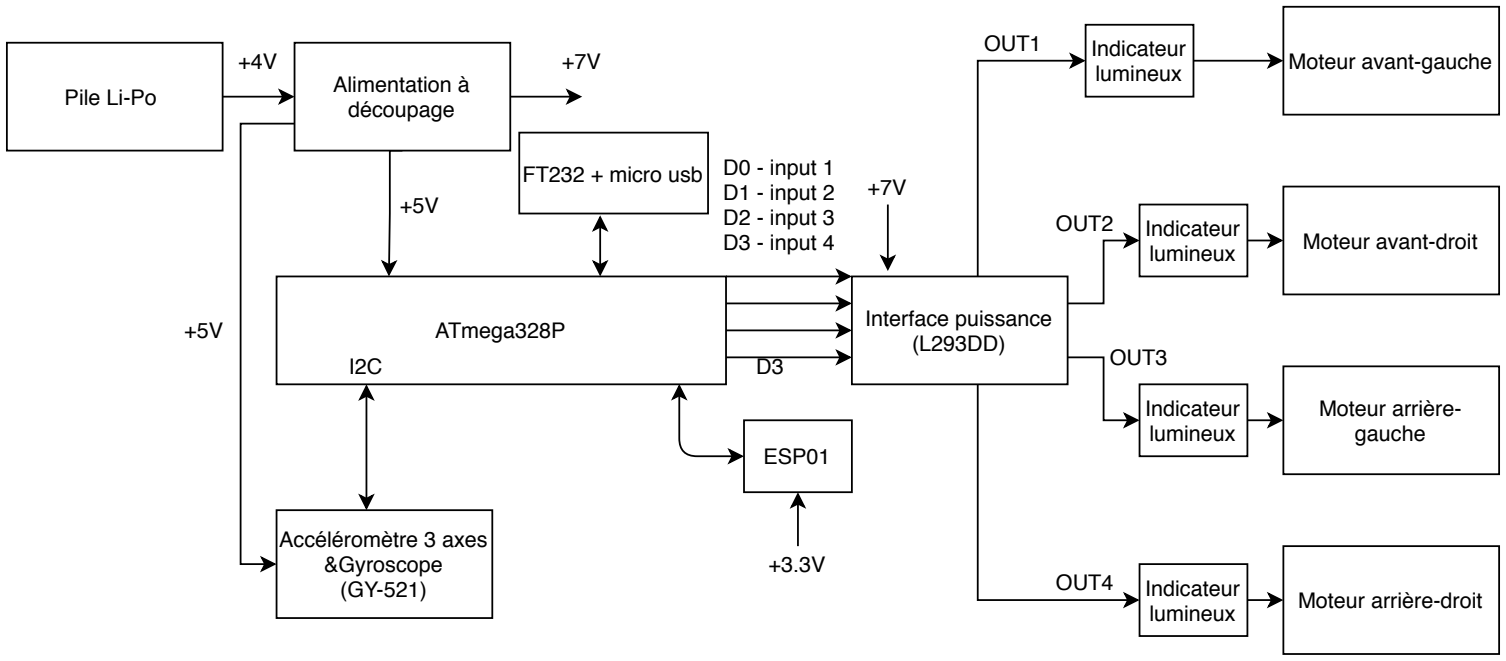
[picture p32: figure]
Pile Li-Po; Alimentation à; découpage; ATmega328P; Accéléromètre 3 axes &Gyroscope (GY-521); Interface puissance; Moteur avant-gauche; Moteur avant-droit; Moteur arrière- gauche; Moteur arrière-droit; ESP01; OUT1; D0 - input 1 D1 - input 2 D2 - input 3 D3 - input 4; Indicateur lumineux; FT232 + micro usb; OUT2; OUT3; OUT4
