KnArF9/projetDrone/Drone/electronique_drone/electronique_drone.kicad_pcb

## KiCad design Drone/electronique_drone/electronique_drone.kicad_pcb (2020-10-29)

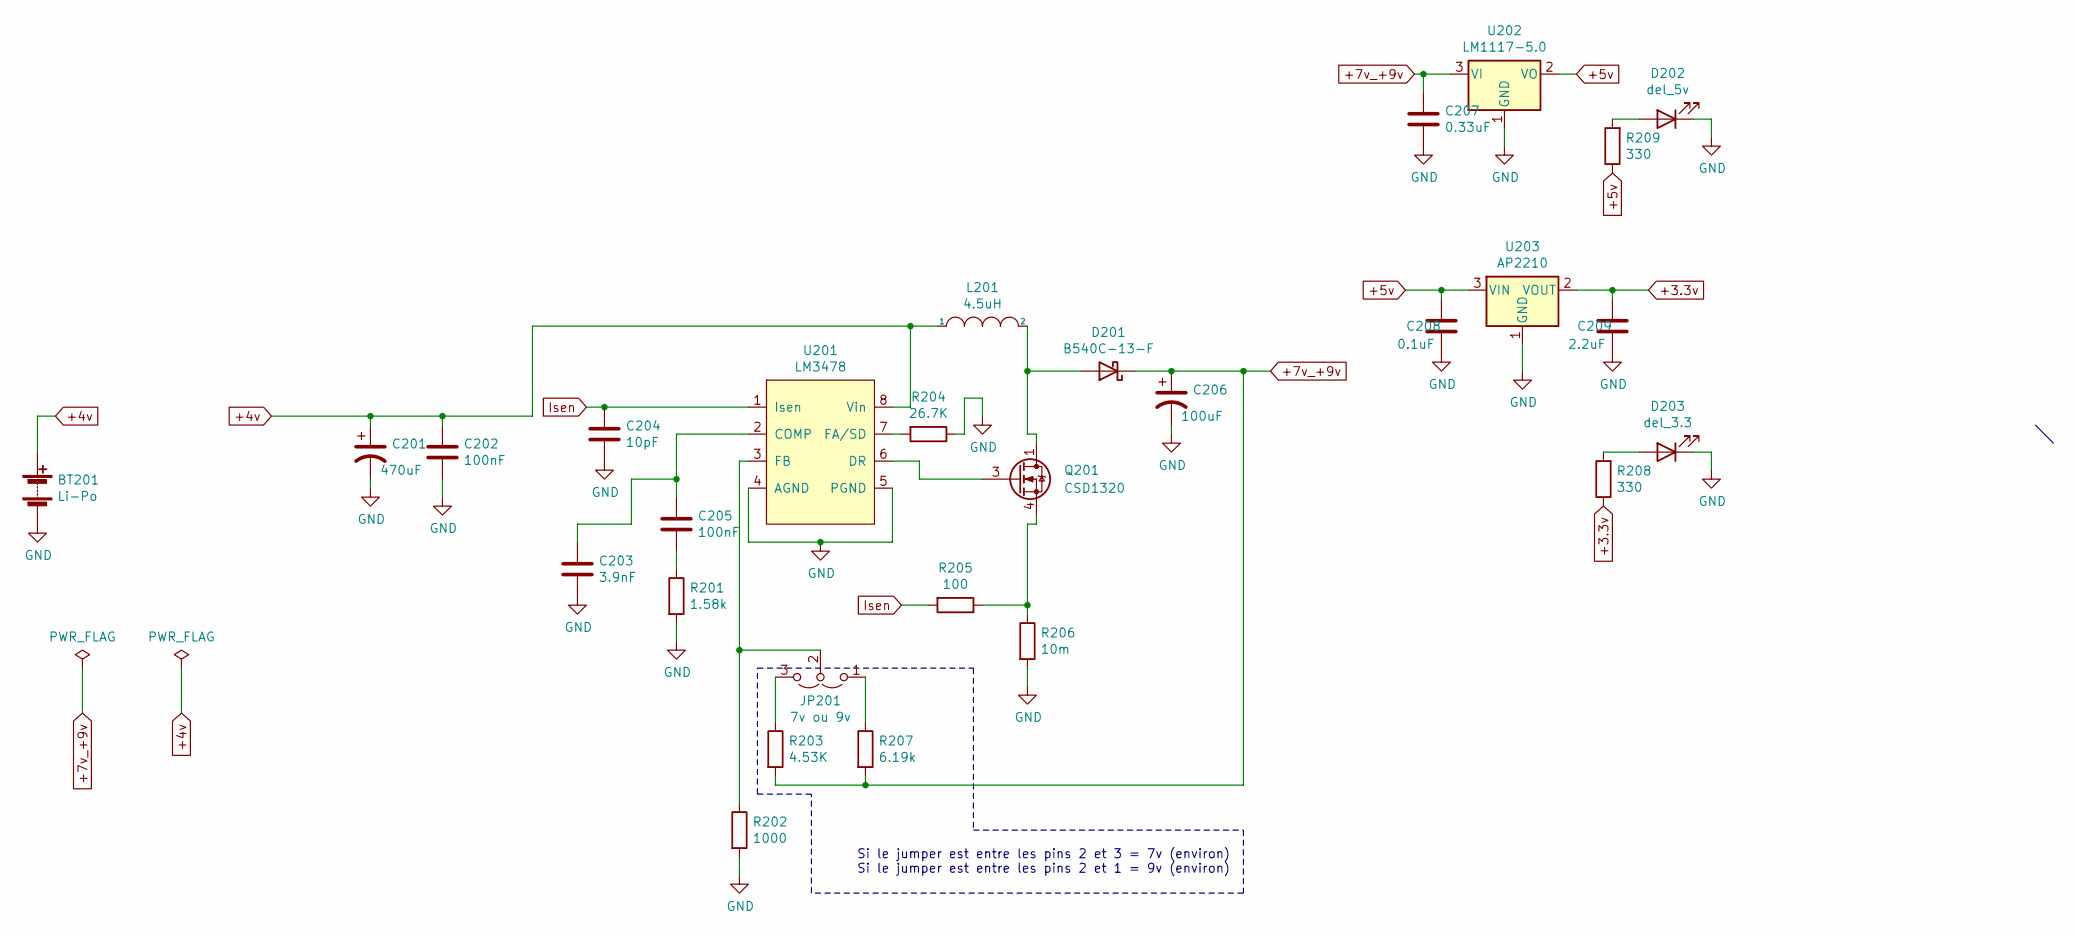
[picture p33: schematic Alim.sch, Alimentation]

Parts:
BT201: Li-Po; PinHeader_1x02_P2.54mm_Vertical
C201: 470uF; CP_Elec_8x11.9
C202, C205: 100nF; R_0805_2012Metric
C203: 3.9nF; R_0805_2012Metric
C204: 10pF; R_0805_2012Metric
C206: 100uF; CP_Elec_6.3x3
C207: 0.33uF; R_0805_2012Metric
C208: 0.1uF; R_0805_2012Metric
C209: 2.2uF; R_0805_2012Metric
D201: B540C-13-F; D_SMB-SMC_Universal_Handsoldering
D202: del_5v; R_0805_2012Metric
D203: del_3.3; R_0805_2012Metric
JP201: 7v ou 9v; PinHeader_1x03_P2.54mm_Vertical
L201: 4.5uH; L_Bourns_SRR1210A
Q201: CSD1320; CSD13202Q2
R201: 1.58k; R_0805_2012Metric
R202: 1000; R_0805_2012Metric
R203: 4.53K; R_0805_2012Metric
R204: 26.7K; R_0805_2012Metric
R205: 100; R_0805_2012Metric
R206: 10m; R_1206_3216Metric
R207: 6.19k; R_0805_2012Metric
R208, R209: 330; R_0805_2012Metric
U201: LM3478; SSOP-8_2.95x2.8mm_P0.65mm
U202: LM1117-5.0; SOT-223-3_TabPin2
U203: AP2210; SOT-23_Handsoldering

Connections:
+3.3v: C209.1, R208.1, U203.2 (VOUT); also elsewhere on the board
+4v: BT201.1 (+), C201.1, C202.1, L201.1, U201.8 (Vin)
+5v: C208.1, R209.1, U202.2 (VO), U203.3 (VIN); also elsewhere on the board
+7v_+9v: C206.1, C207.1, D201.1 (K), R203.2, R207.2, U202.3 (VI); also elsewhere on the board
GND: BT201.2 (-), C201.2, C202.2, C203.2, C204.2, C206.2, C207.2, C208.2, C209.2, D202.1 (K), D203.1 (K), R201.2, R202.2, R204.1, R206.2, U201.4 (AGND), U201.5 (PGND), U202.1 (GND), U203.1 (GND); also elsewhere on the board
Isen: C204.1, R205.2, U201.1 (Isen)
unnamed: C203.1, C205.1, U201.2 (COMP)
unnamed: C205.2, R201.1
unnamed: D201.2 (A), L201.2, Q201.1 (D), Q201.2 (D), Q201.5 (D), Q201.6 (D), Q201.8 (D)
unnamed: D202.2 (A), R209.2
unnamed: D203.2 (A), R208.2
unnamed: JP201.1 (A), R207.1
unnamed: JP201.2 (C), R202.1, U201.3 (FB)
unnamed: JP201.3 (B), R203.1
unnamed: Q201.3 (G), U201.6 (DR)
unnamed: Q201.4 (D), Q201.7 (S), R205.1, R206.1
unnamed: R204.2, U201.7 (FA/SD)

Notes on the sheet:
Si le jumper est entre les pins 2 et 3 = 7v (environ) Si le jumper est entre les pins 2 et 1 = 9v (environ)

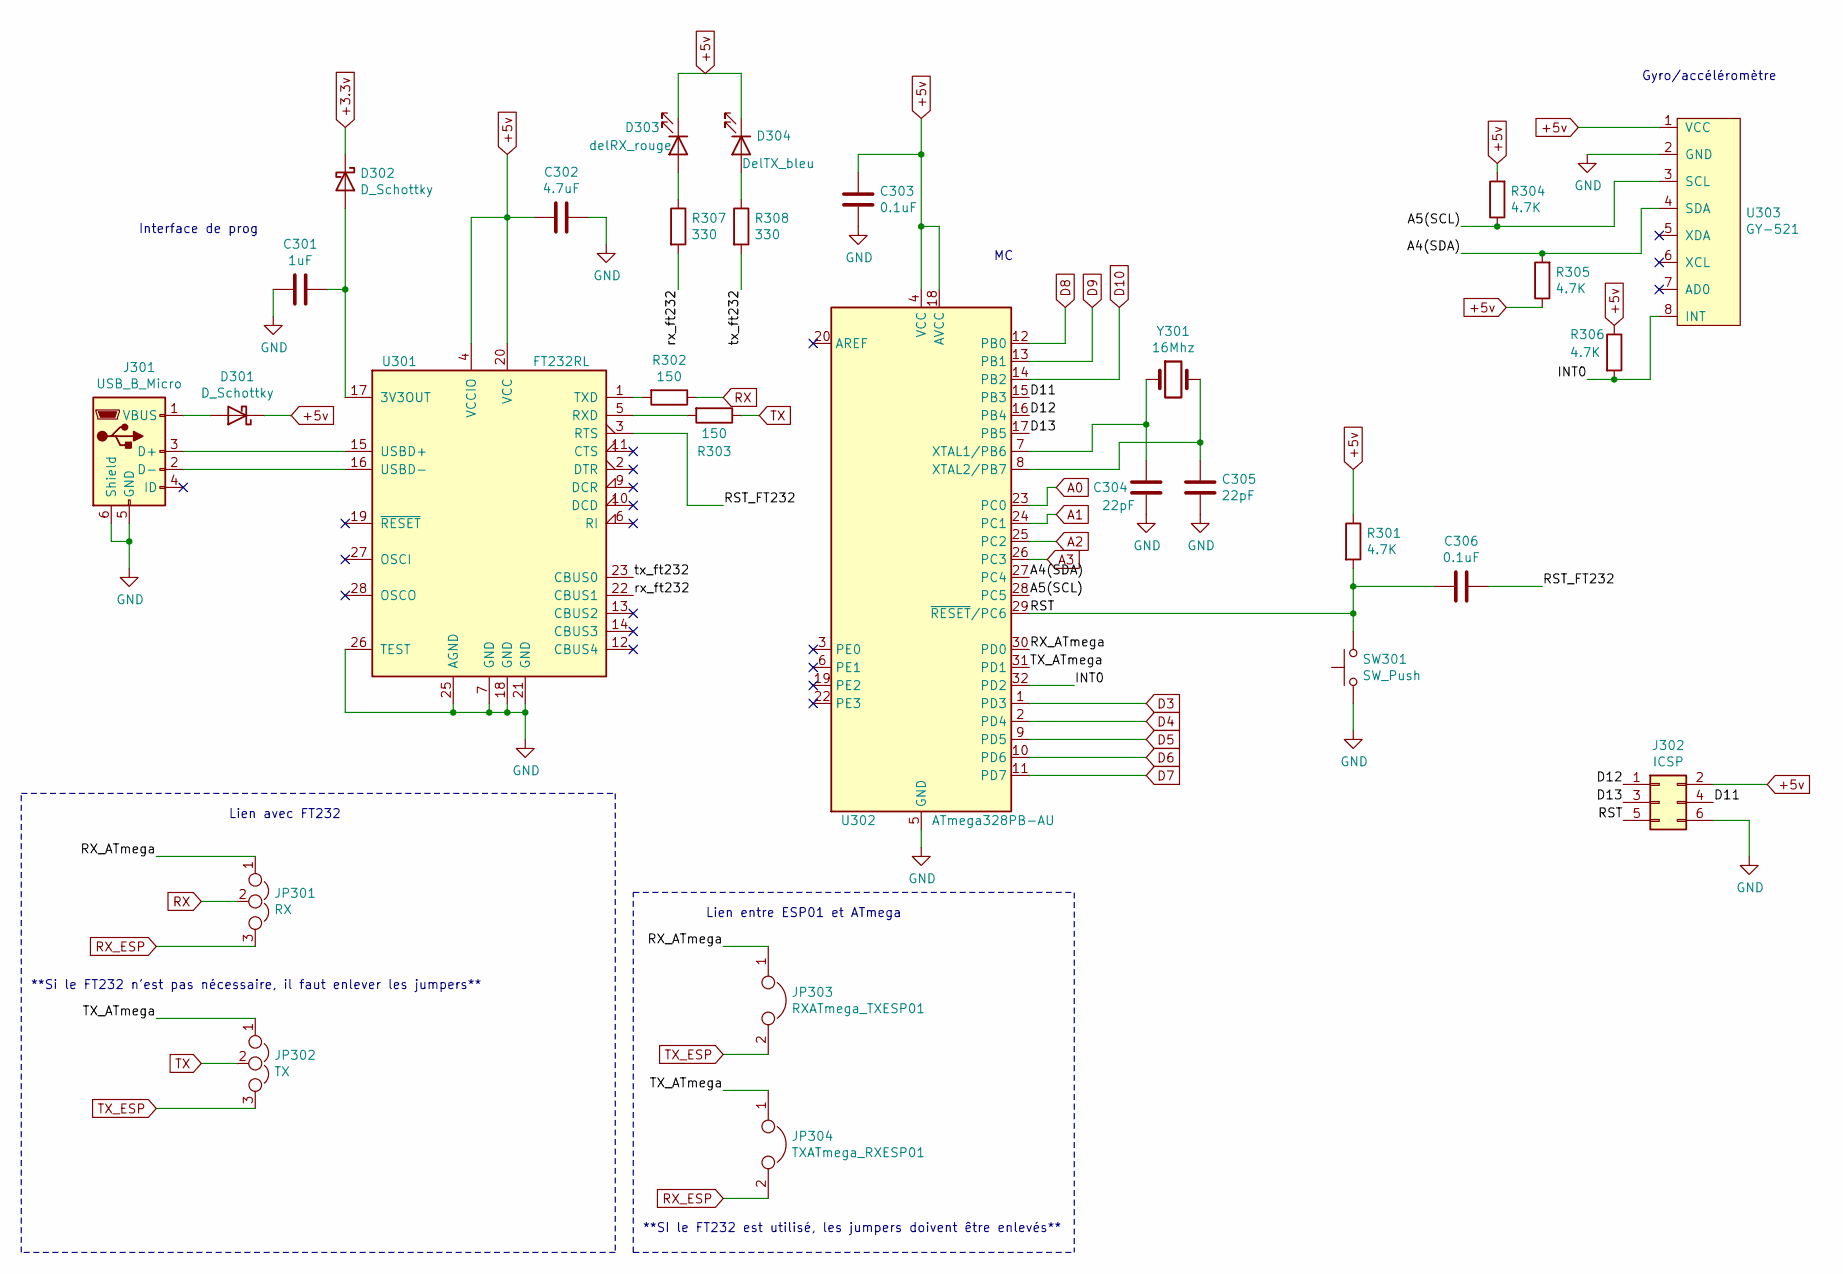
[picture p34: schematic MC.sch, MC/InterfaceProg/Capteur]

Parts:
C301: 1uF; R_0805_2012Metric
C302: 4.7uF; R_0805_2012Metric
C303, C306: 0.1uF; R_0805_2012Metric
C304, C305: 22pF; R_0805_2012Metric
D301, D302: D_Schottky; R_0805_2012Metric
D303: delRX_rouge; R_0805_2012Metric
D304: DelTX_bleu; R_0805_2012Metric
J301: USB_B_Micro; USB_Mini-B_Lumberg_2486_01_Horizontal
J302: ICSP; PinHeader_2x03_P2.54mm_Vertical
JP301: RX; PinHeader_1x03_P2.54mm_Vertical
JP302: TX; PinHeader_1x03_P2.54mm_Vertical
JP303: RXATmega_TXESP01; PinHeader_1x02_P2.54mm_Vertical
JP304: TXATmega_RXESP01; PinHeader_1x02_P2.54mm_Vertical
R301, R304, R305, R306: 4.7K; R_0805_2012Metric
R302, R303: 150; R_0805_2012Metric
R307, R308: 330; R_0805_2012Metric
SW301: SW_Push; SW_SPST_FSMSM
U301: FT232RL; SSOP-28_5.3x10.2mm_P0.65mm
U302: ATmega328PB-AU; TQFP-32_7x7mm_P0.8mm
U303: GY-521; PinSocket_1x08_P2.54mm_Vertical
Y301: 16Mhz; Crystal_SMD_Abracon_ABM3-2Pin_5.0x3.2mm

Connections:
+3.3v: D302.1 (K); also elsewhere on the board
+5v: C302.2, C303.1, D301.1 (K), D303.1 (K), D304.1 (K), J302.2, R301.1, R304.2, R305.1, R306.1, U301.4 (VCCIO), U301.20 (VCC), U302.4 (VCC), U302.18 (AVCC), U303.1 (VCC); also elsewhere on the board
/MC/InterfaceProg/Capteur/A4(SDA): R305.2, U302.27 (PC4), U303.4 (SDA)
/MC/InterfaceProg/Capteur/A5(SCL): R304.1, U302.28 (PC5), U303.3 (SCL)
/MC/InterfaceProg/Capteur/D11: J302.4, U302.15 (PB3)
/MC/InterfaceProg/Capteur/D12: J302.1, U302.16 (PB4)
/MC/InterfaceProg/Capteur/D13: J302.3, U302.17 (PB5)
/MC/InterfaceProg/Capteur/INT0: R306.2, U302.32 (PD2), U303.8 (INT)
/MC/InterfaceProg/Capteur/RST: C306.2, J302.5, R301.2, SW301.2, U302.29 (~RESET~/PC6)
/MC/InterfaceProg/Capteur/RST_FT232: C306.1, U301.3 (RTS)
/MC/InterfaceProg/Capteur/RX_ATmega: JP301.1, JP303.1, U302.30 (PD0)
/MC/InterfaceProg/Capteur/TX_ATmega: JP302.1, JP304.1, U302.31 (PD1)
/MC/InterfaceProg/Capteur/rx_ft232: R307.2, U301.22 (CBUS1)
/MC/InterfaceProg/Capteur/tx_ft232: R308.2, U301.23 (CBUS0)
A0: U302.23 (PC0); also elsewhere on the board
A1: U302.24 (PC1); also elsewhere on the board
A2: U302.25 (PC2); also elsewhere on the board
A3: U302.26 (PC3); also elsewhere on the board
D3: U302.1 (PD3); also elsewhere on the board
D4: U302.2 (PD4); also elsewhere on the board
D5: U302.9 (PD5); also elsewhere on the board
D6: U302.10 (PD6); also elsewhere on the board
D7: U302.11 (PD7); also elsewhere on the board
D8: U302.12 (PB0); also elsewhere on the board
D9: U302.13 (PB1); also elsewhere on the board
D10: U302.14 (PB2); also elsewhere on the board
GND: C301.2, C302.1, C303.2, C304.2, C305.2, J301.5 (GND), J301.6 (Shield), J302.6, SW301.1, U301.7 (GND), U301.18 (GND), U301.21 (GND), U301.25 (AGND), U301.26 (TEST), U302.5 (GND), U302.21 (GND), U303.2 (GND); also elsewhere on the board
unnamed: C301.1, D302.2 (A), U301.17 (3V3OUT)
unnamed: C304.1, U302.7 (XTAL1/PB6), Y301.1
unnamed: C305.1, U302.8 (XTAL2/PB7), Y301.2
unnamed: D301.2 (A), J301.1 (VBUS)
unnamed: D303.2 (A), R307.1
unnamed: D304.2 (A), R308.1
unnamed: J301.2 (D-), U301.16 (USBD-)
unnamed: J301.3 (D+), U301.15 (USBD+)
unnamed: R302.2, U301.1 (TXD)
unnamed: R303.2, U301.5 (RXD)
RX: JP301.2, R302.1
RX_ESP: JP301.3, JP304.2; also elsewhere on the board
TX: JP302.2, R303.1
TX_ESP: JP302.3, JP303.2; also elsewhere on the board

Notes on the sheet:
Gyro/accéléromètre
Interface de prog
**Si le FT232 n'est pas nécessaire, il faut enlever les jumpers**
Lien avec FT232
Lien entre ESP01 et ATmega
**SI le FT232 est utilisé, les jumpers doivent être enlevés**

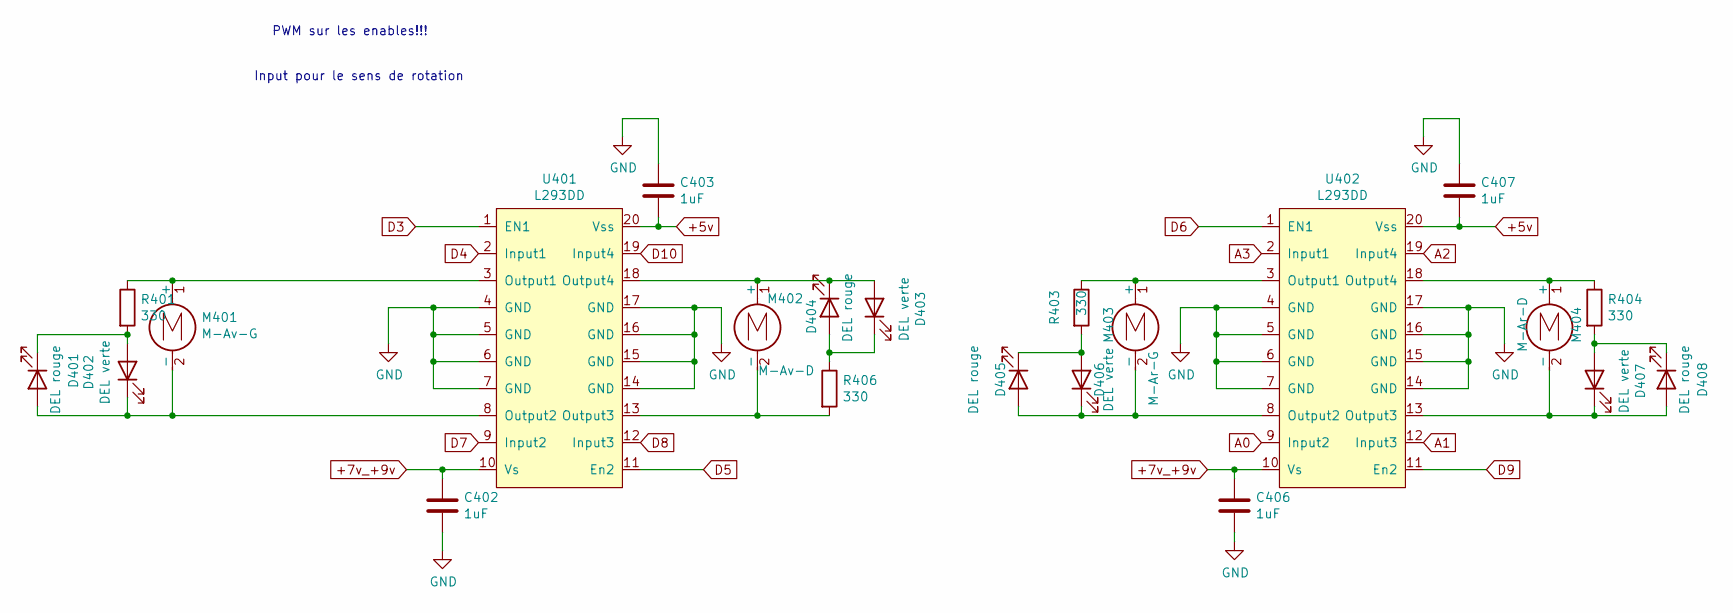
[picture p35: schematic Puissance.sch, Puissance/Indicateur/moteur]

Parts:
C402, C403, C406, C407: 1uF; R_0805_2012Metric
D401, D404, D405, D408: DEL rouge; R_0805_2012Metric
D402, D403, D406, D407: DEL verte; R_0805_2012Metric
M401: M-Av-G; PinSocket_1x02_P2.54mm_Vertical
M402: M-Av-D; PinSocket_1x02_P2.54mm_Vertical
M403: M-Ar-G; PinSocket_1x02_P2.54mm_Vertical
M404: M-Ar-D; PinSocket_1x02_P2.54mm_Vertical
R401, R403, R404, R406: 330; R_0805_2012Metric
U401, U402: L293DD; SO-20_12.8x7.5mm_P1.27mm

Connections:
+5v: C403.2, C407.2, U401.20 (Vss), U402.20 (Vss); also elsewhere on the board
+7v_+9v: C402.1, C406.1, U401.10 (Vs), U402.10 (Vs); also elsewhere on the board
A0: U402.9 (Input2); also elsewhere on the board
A1: U402.12 (Input3); also elsewhere on the board
A2: U402.19 (Input4); also elsewhere on the board
A3: U402.2 (Input1); also elsewhere on the board
D3: U401.1 (EN1); also elsewhere on the board
D4: U401.2 (Input1); also elsewhere on the board
D5: U401.11 (En2); also elsewhere on the board
D6: U402.1 (EN1); also elsewhere on the board
D7: U401.9 (Input2); also elsewhere on the board
D8: U401.12 (Input3); also elsewhere on the board
D9: U402.11 (En2); also elsewhere on the board
D10: U401.19 (Input4); also elsewhere on the board
GND: C402.2, C403.1, C406.2, C407.1, U401.4 (GND), U401.5 (GND), U401.6 (GND), U401.7 (GND), U401.14 (GND), U401.15 (GND), U401.16 (GND), U401.17 (GND), U402.4 (GND), U402.5 (GND), U402.6 (GND), U402.7 (GND), U402.14 (GND), U402.15 (GND), U402.16 (GND), U402.17 (GND); also elsewhere on the board
unnamed: D401.1 (K), D402.2 (A), R401.2
unnamed: D401.2 (A), D402.1 (K), M401.2 (-), U401.8 (Output2)
unnamed: D403.1 (K), D404.2 (A), R406.1
unnamed: D403.2 (A), D404.1 (K), M402.1 (+), U401.18 (Output4)
unnamed: D405.1 (K), D406.2 (A), R403.2
unnamed: D405.2 (A), D406.1 (K), M403.2 (-), U402.8 (Output2)
unnamed: D407.1 (K), D408.2 (A), M404.2 (-), U402.13 (Output3)
unnamed: D407.2 (A), D408.1 (K), R404.2
unnamed: M401.1 (+), R401.1, U401.3 (Output1)
unnamed: M402.2 (-), R406.2, U401.13 (Output3)
unnamed: M403.1 (+), R403.1, U402.3 (Output1)
unnamed: M404.1 (+), R404.1, U402.18 (Output4)

Notes on the sheet:
PWM sur les enables!!!
Input pour le sens de rotation

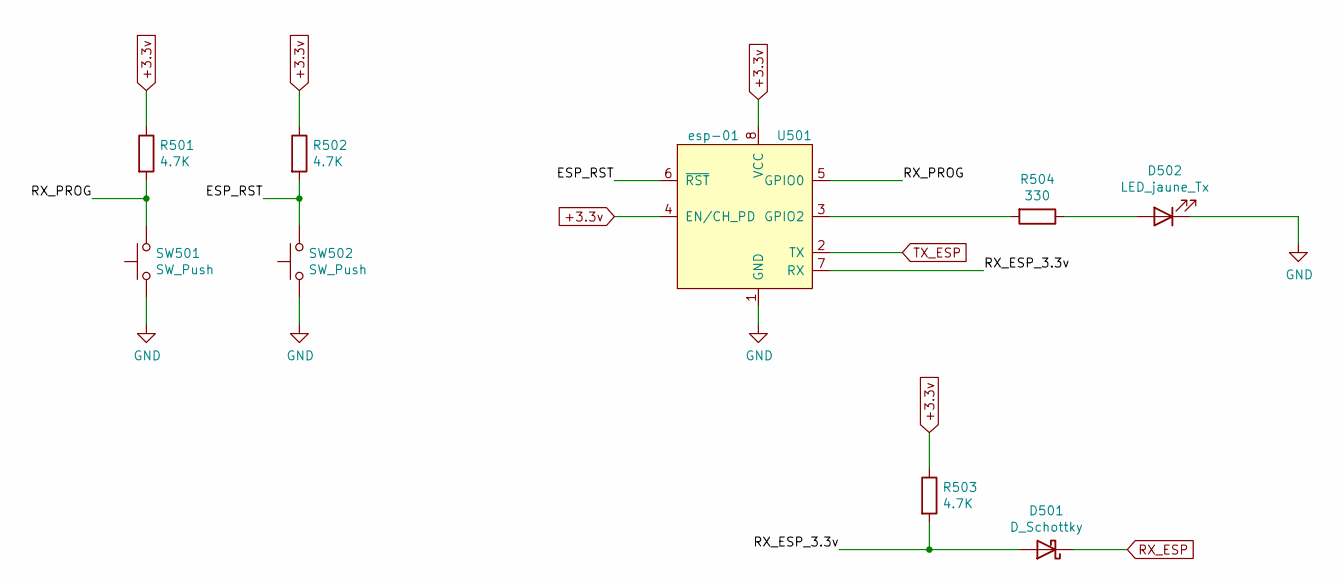
[picture p36: schematic esp01.sch]

Parts:
D501: D_Schottky; R_0805_2012Metric
D502: LED_jaune_Tx; R_0805_2012Metric
R501, R502, R503: 4.7K; R_0805_2012Metric
R504: 330; R_0805_2012Metric
SW501, SW502: SW_Push; SW_SPST_FSMSM
U501: esp-01; PinSocket_2x04_P2.54mm_Vertical

Connections:
+3.3v: R501.1, R502.1, R503.1, U501.4 (EN/CH_PD), U501.8 (VCC); also elsewhere on the board
/ESP01/ESP_RST: R502.2, SW502.2, U501.6 (~RST)
/ESP01/RX_ESP_3.3v: D501.2 (A), R503.2, U501.7 (RX)
/ESP01/RX_PROG: R501.2, SW501.2, U501.5 (GPIO0)
GND: D502.1 (K), SW501.1, SW502.1, U501.1 (GND); also elsewhere on the board
unnamed: D502.2 (A), R504.1
unnamed: R504.2, U501.3 (GPIO2)
RX_ESP: D501.1 (K); also elsewhere on the board
TX_ESP: U501.2 (TX); also elsewhere on the board

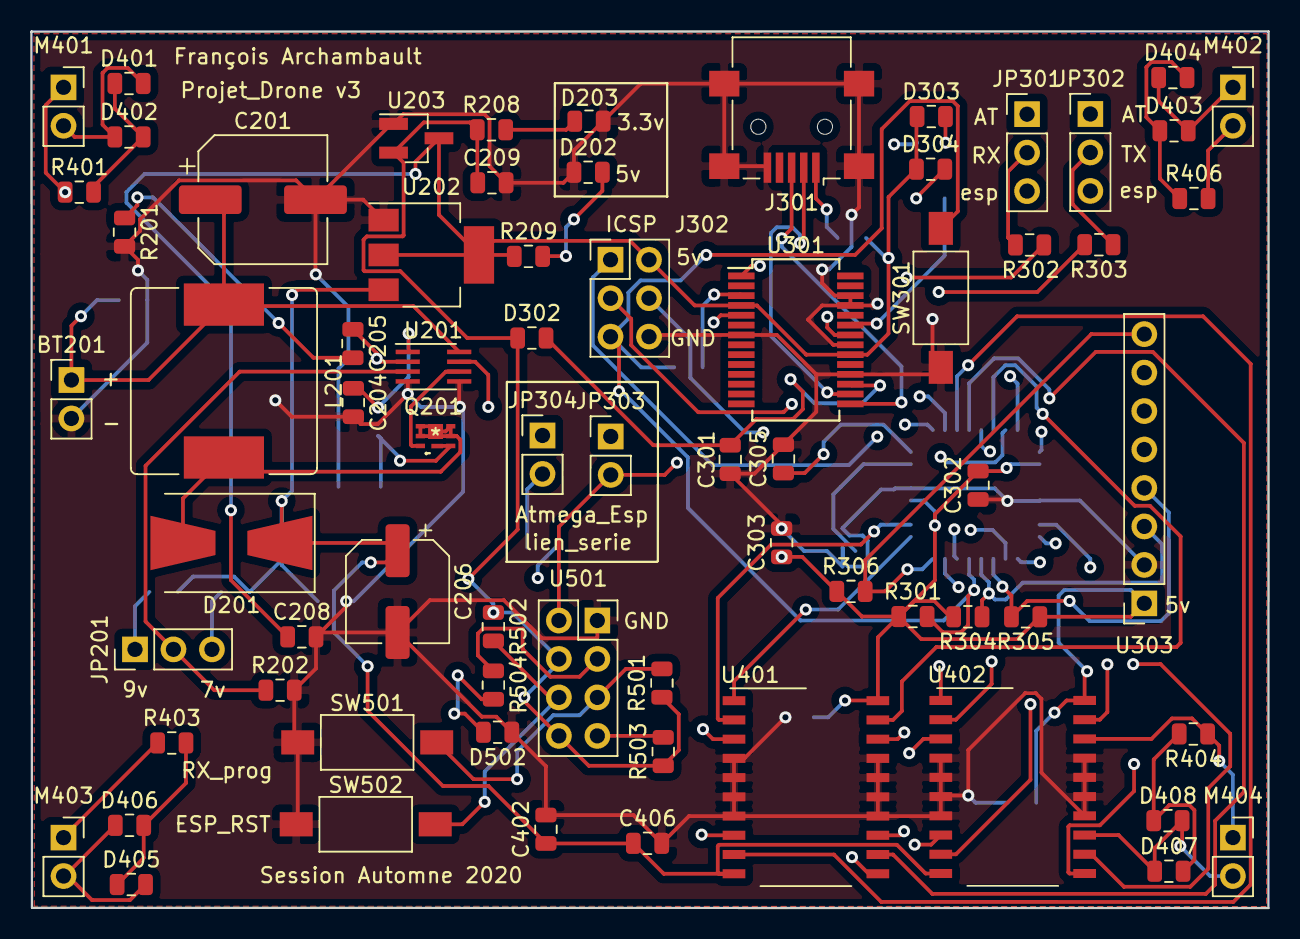
[picture p37: board electronique_drone.kicad_pcb from above]

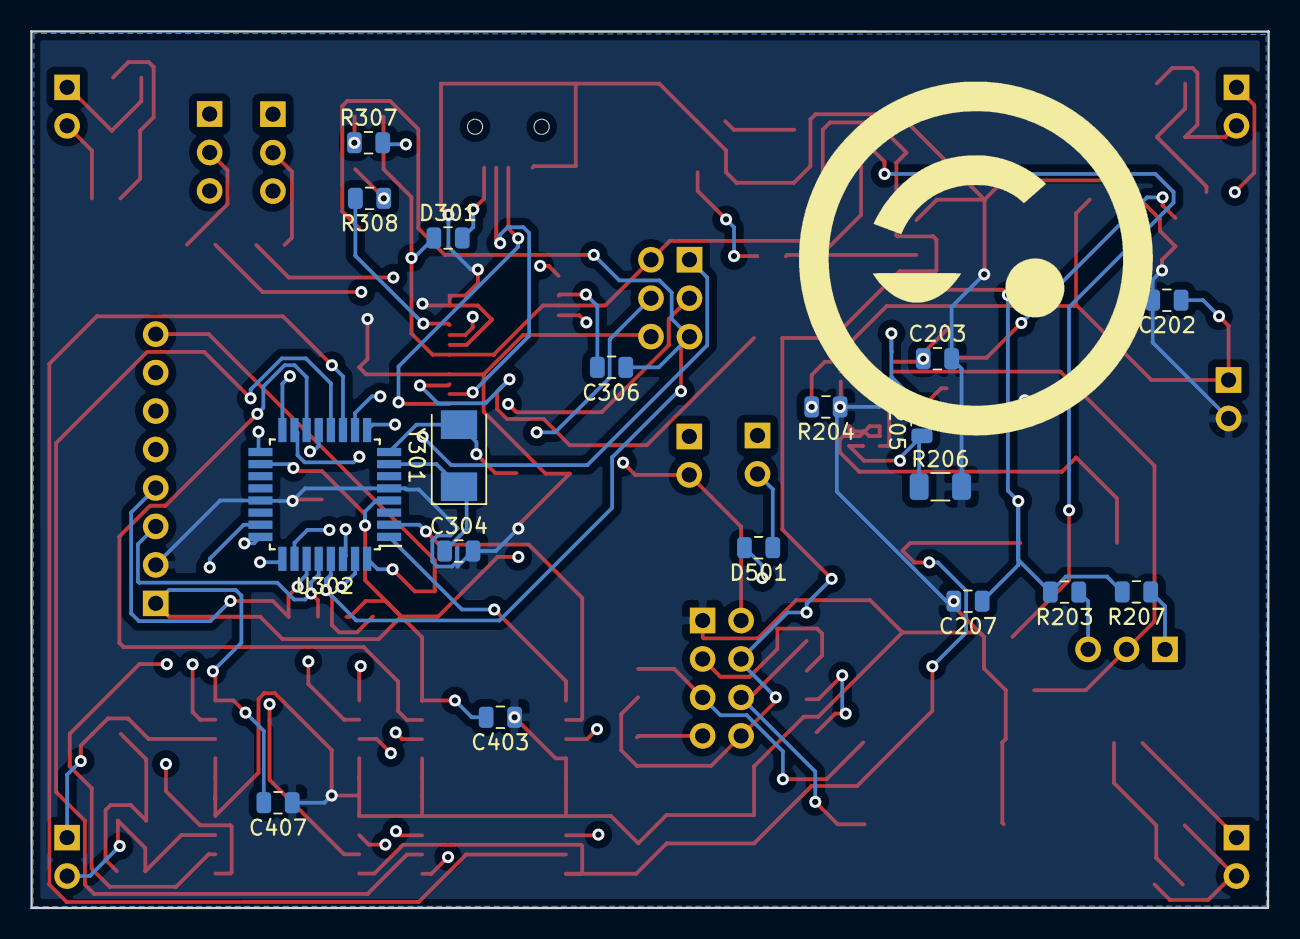
[picture p38: board electronique_drone.kicad_pcb from below]

Board: 4 copper layers, 81.7 x 57.9 mm, 88 parts (18 on the bottom side), 72 nets.
